LHC0821/2026TI-match-ball-system/hardware/mech/顶端一体件.SLDASM

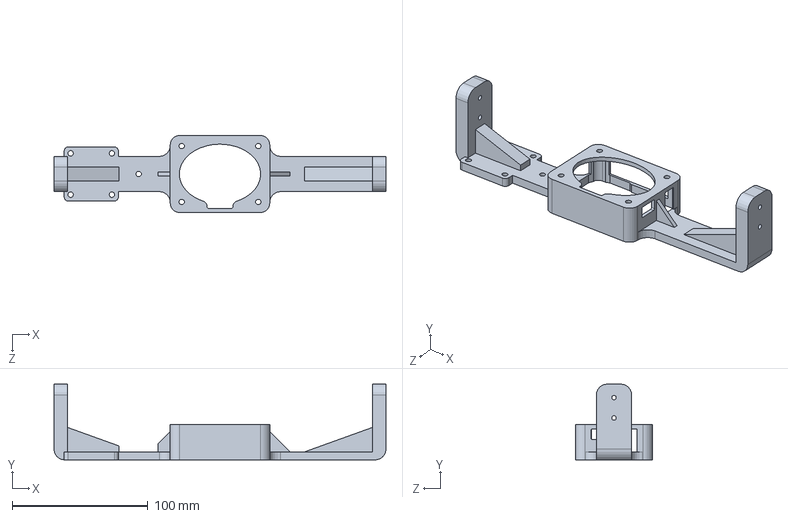
[picture p1: CAD file, 2026-10-28]
hardware/mech/顶端一体件.SLDASM
245.0 x 56.0 x 56.8 mm
