LHC0821/2026TI-match-ball-system/hardware/mech/起始转接件（合页）.SLDPRT

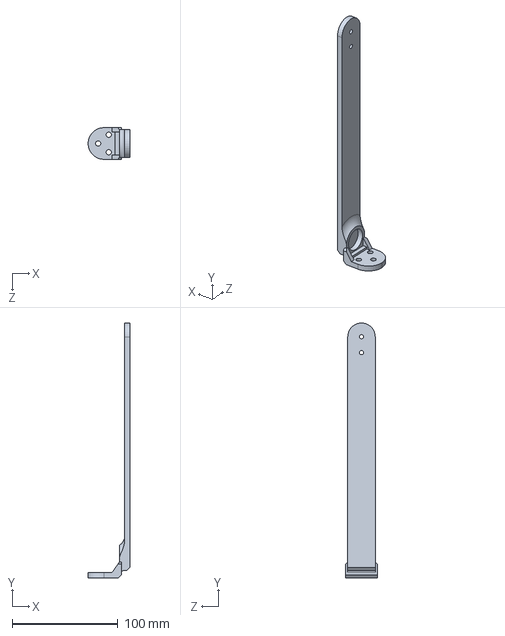
[picture p2: CAD file, 2026-10-28]
hardware/mech/起始转接件（合页）.SLDPRT
39.5 x 241.0 x 30.0 mm
