LHC0821/2026TI-match-ball-system/hardware/mech/定向轮支架.SLDPRT

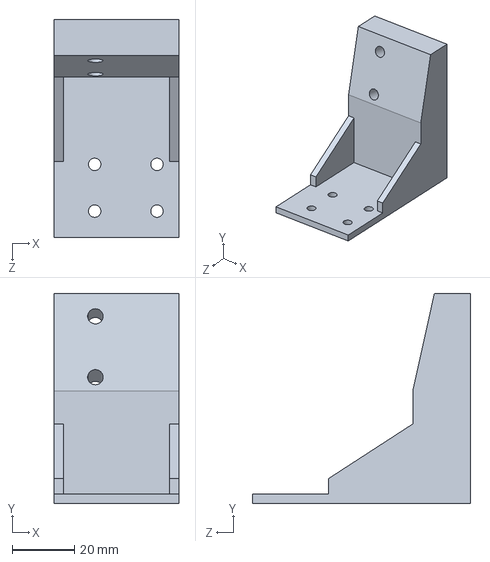
[picture p3: CAD file, 2026-10-28]
hardware/mech/定向轮支架.SLDPRT
40.0 x 67.4 x 70.0 mm
