LHC0821/2026TI-match-ball-system/hardware/mech/24v电池盒.SLDPRT

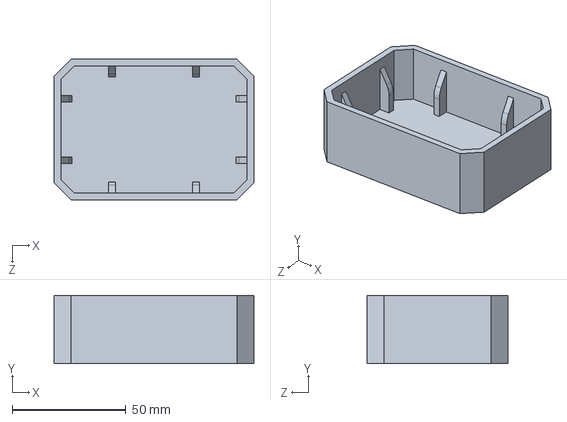
[picture p4: CAD file, 2026-10-28]
hardware/mech/24v电池盒.SLDPRT
88.0 x 30.0 x 62.0 mm
