LHC0821/2026TI-match-ball-system/hardware/mech/达妙MC02连接板.SLDPRT

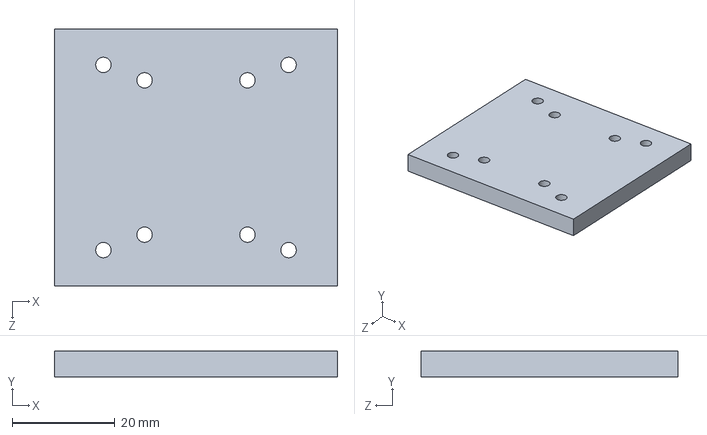
[picture p5: CAD file, 2026-10-28]
hardware/mech/达妙MC02连接板.SLDPRT
55.0 x 5.00 x 50.0 mm
