LHC0821/2026TI-match-ball-system/hardware/mech/内啮合末端圆柱齿轮256×2.SLDPRT

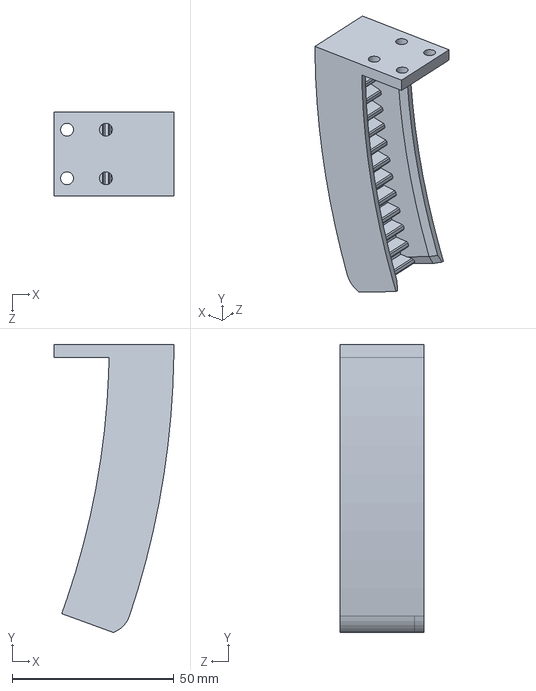
[picture p6: CAD file, 2026-10-28]
hardware/mech/内啮合末端圆柱齿轮256×2.SLDPRT
37.0 x 88.9 x 26.0 mm
