LHC0821/2026TI-match-ball-system/hardware/mech/达妙开发板（简约版）.SLDPRT

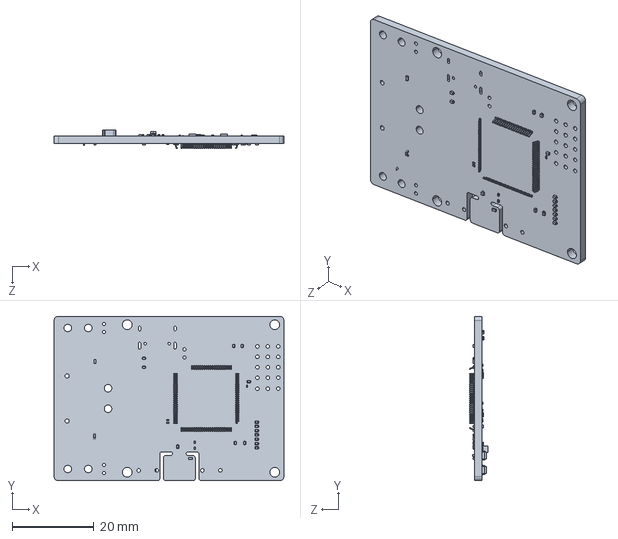
[picture p7: CAD file, 2026-10-28]
hardware/mech/达妙开发板（简约版）.SLDPRT
56.1 x 40.1 x 4.93 mm
