LHC0821/2026TI-match-ball-system/hardware/mech/万向轮（简易版）.SLDPRT

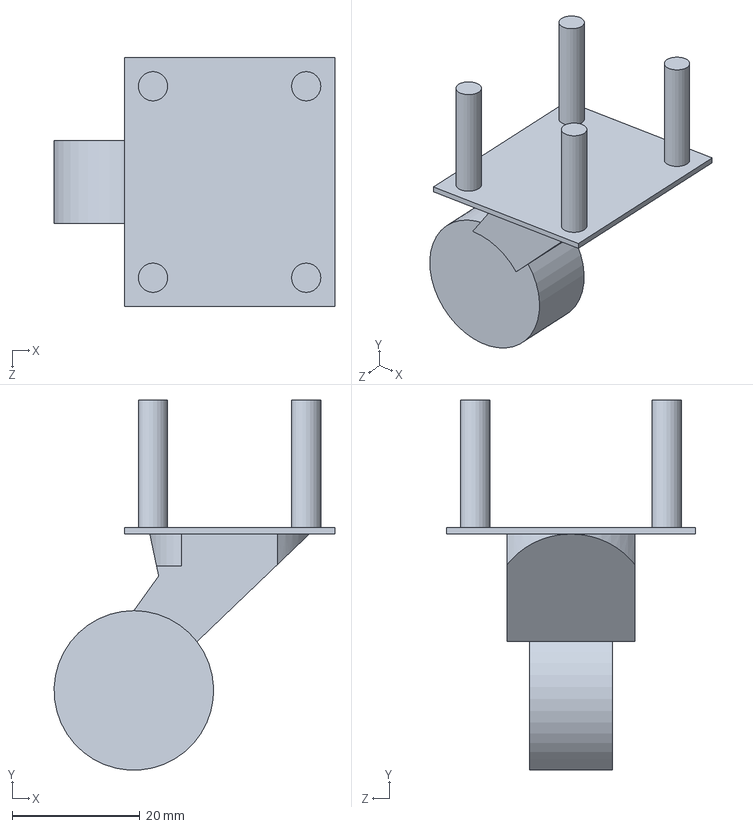
[picture p8: CAD file, 2026-10-28]
hardware/mech/万向轮（简易版）.SLDPRT
44.0 x 58.0 x 39.0 mm
