LHC0821/2026TI-match-ball-system/hardware/mech/铰链（长）.SLDPRT

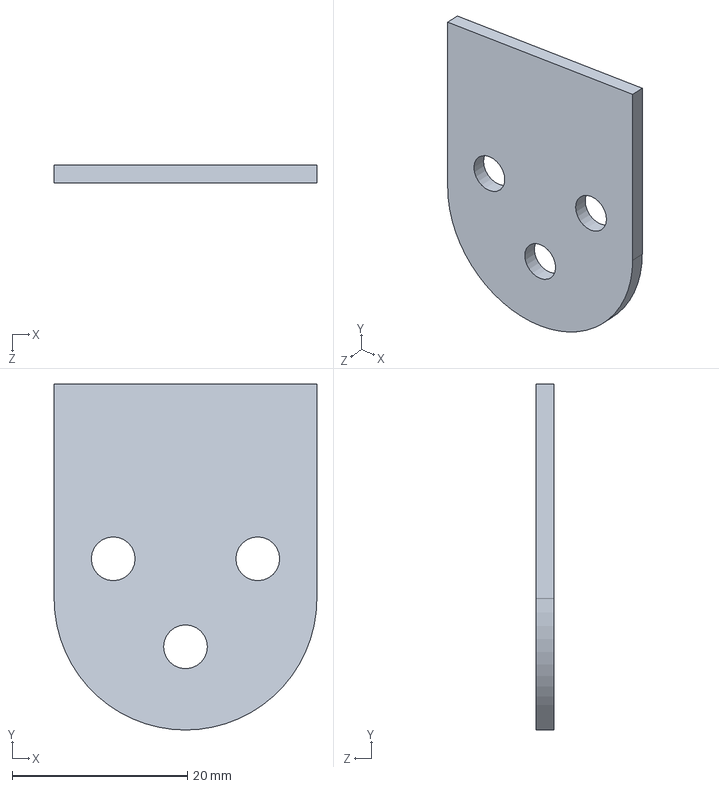
[picture p9: CAD file, 2026-10-28]
hardware/mech/铰链（长）.SLDPRT
30.0 x 39.5 x 2.00 mm
