LHC0821/2026TI-match-ball-system/hardware/mech/关节电机固定架.SLDPRT

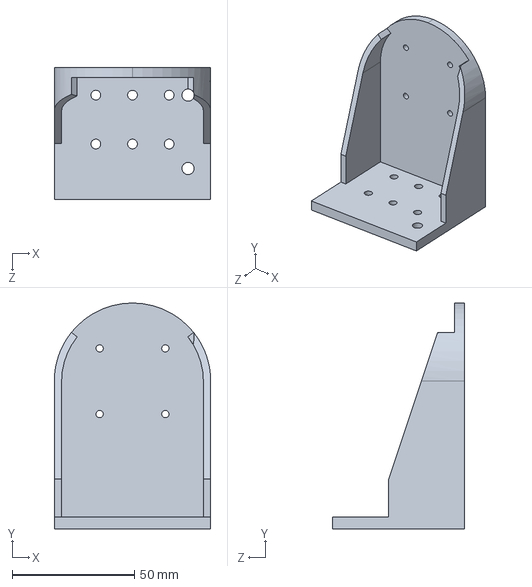
[picture p10: CAD file, 2026-10-28]
hardware/mech/关节电机固定架.SLDPRT
64.0 x 92.4 x 54.0 mm
