LHC0821/2026TI-match-ball-system/hardware/mech/管道左固定架.SLDPRT

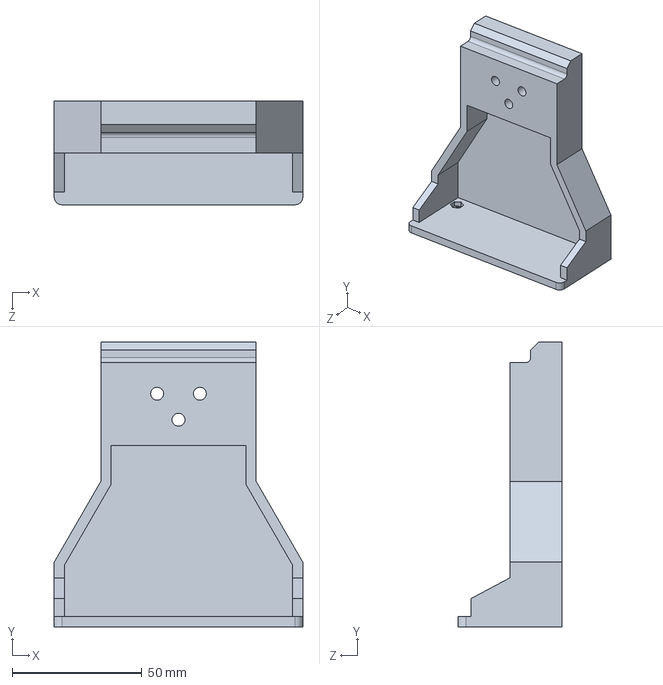
[picture p11: CAD file, 2026-10-28]
hardware/mech/管道左固定架.SLDPRT
96.0 x 110.0 x 40.0 mm
