LHC0821/2026TI-match-ball-system/hardware/mech/铜柱（单通M3长25+5）【灰度传感器】.SLDPRT

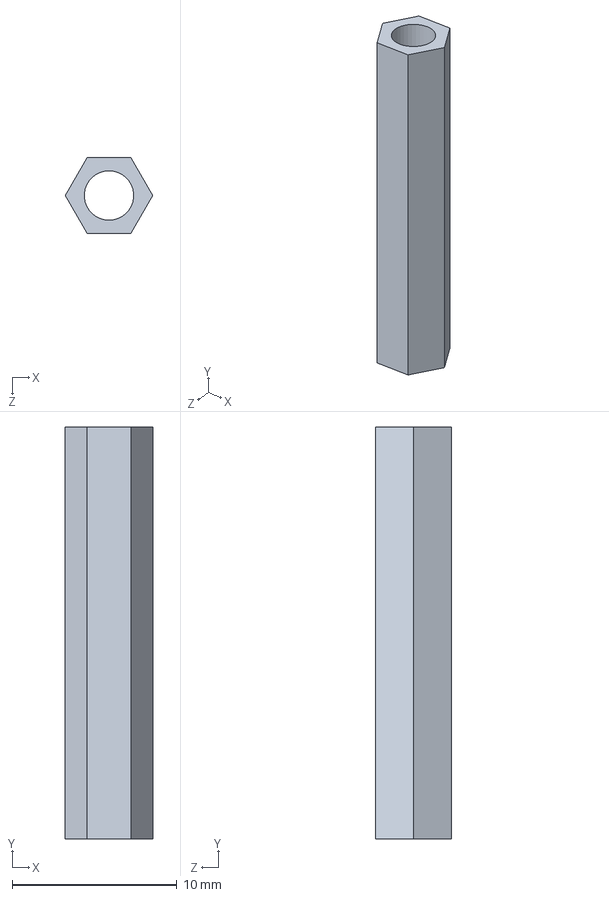
[picture p12: CAD file, 2026-10-28]
hardware/mech/铜柱（单通M3长25+5）【灰度传感器】.SLDPRT
5.31 x 25.0 x 4.60 mm
