LHC0821/2026TI-match-ball-system/hardware/mech/电池.SLDPRT

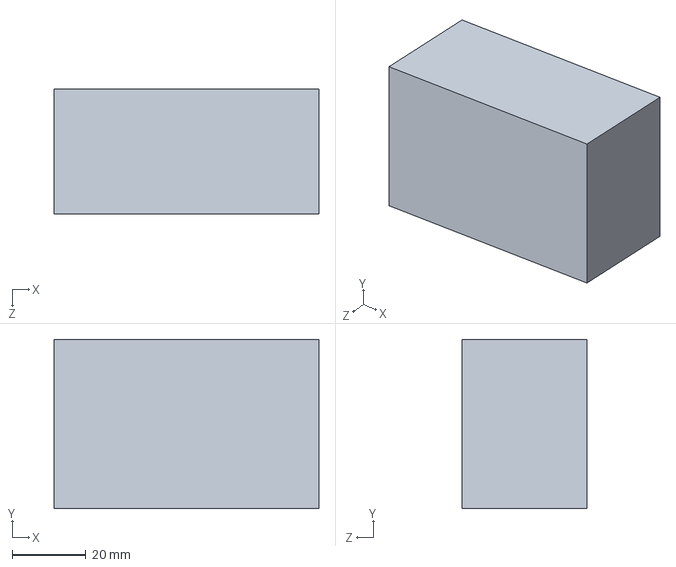
[picture p13: CAD file, 2026-10-28]
hardware/mech/电池.SLDPRT
72.0 x 46.0 x 34.0 mm
