LHC0821/2026TI-match-ball-system/hardware/mech/直流电机—MG513X霍尔编码器+支架+65mm轮子（客户图）.SLDPRT

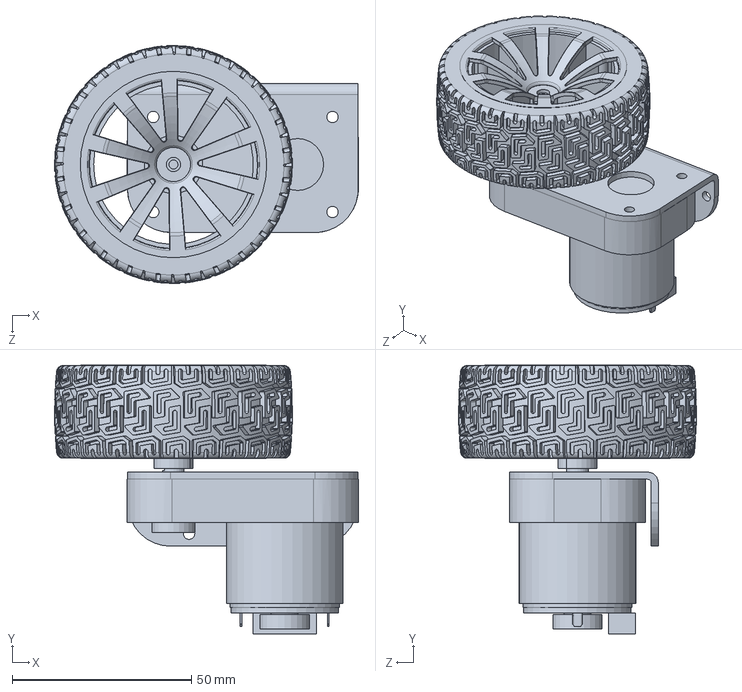
[picture p14: CAD file, 2026-10-28]
hardware/mech/直流电机—MG513X霍尔编码器+支架+65mm轮子（客户图）.SLDPRT
84.8 x 74.9 x 66.4 mm
