LHC0821/2026TI-match-ball-system/hardware/mech/后壳.SLDPRT

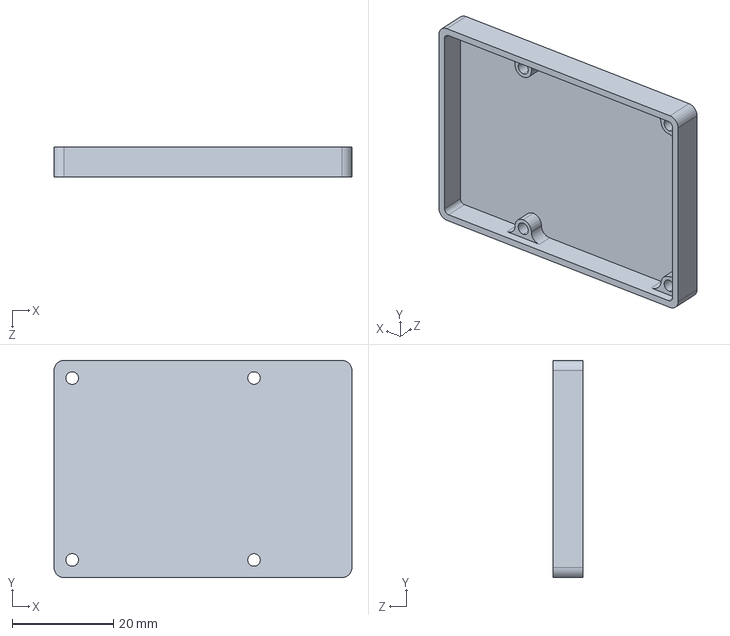
[picture p15: CAD file, 2026-10-28]
hardware/mech/后壳.SLDPRT
59.0 x 43.0 x 6.00 mm
