LHC0821/2026TI-match-ball-system/hardware/mech/主动轮圆柱齿轮27×2【驱动】.SLDPRT

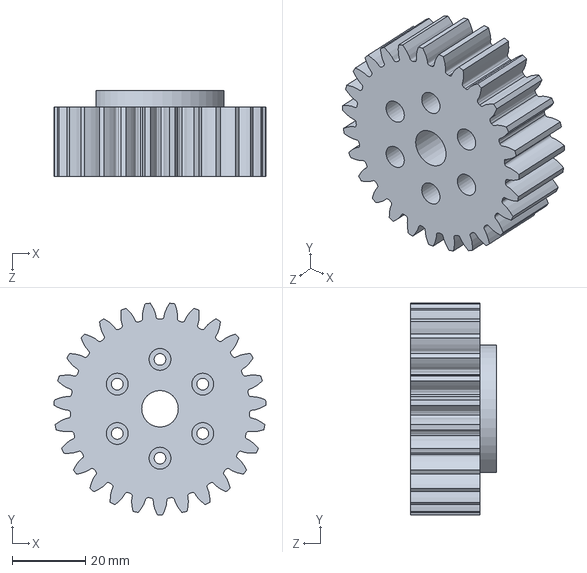
[picture p16: CAD file, 2026-10-28]
hardware/mech/主动轮圆柱齿轮27×2【驱动】.SLDPRT
58.0 x 57.9 x 23.5 mm
