LHC0821/2026TI-match-ball-system/hardware/mech/小车底板.SLDPRT

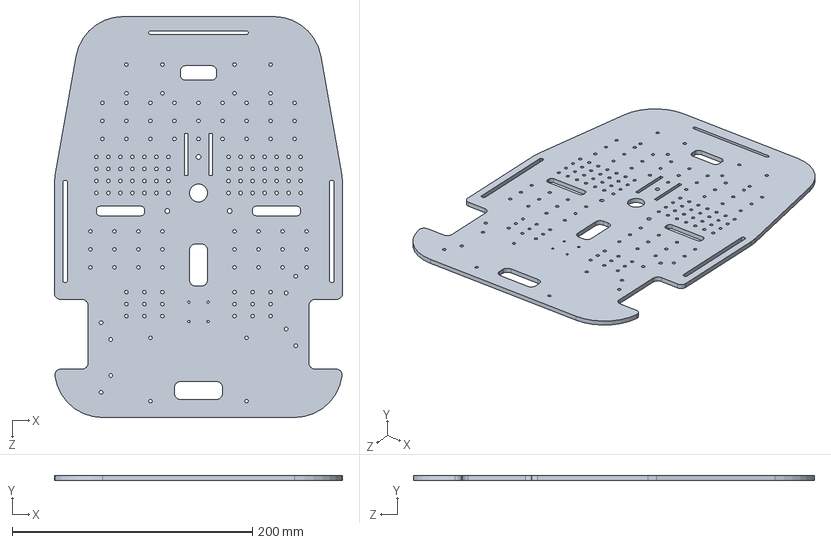
[picture p17: CAD file, 2026-10-28]
hardware/mech/小车底板.SLDPRT
240.0 x 4.00 x 334.0 mm
