LHC0821/2026TI-match-ball-system/hardware/mech/ppr水管.SLDPRT

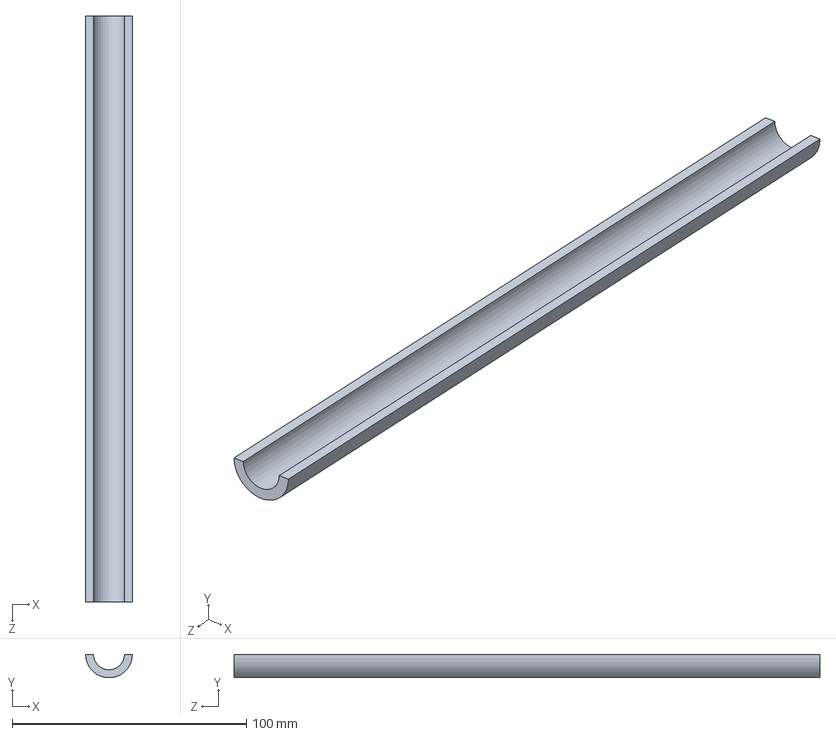
[picture p18: CAD file, 2026-10-28]
hardware/mech/ppr水管.SLDPRT
20.0 x 9.97 x 250.0 mm
