LHC0821/2026TI-match-ball-system/hardware/mech/开发板.SLDPRT

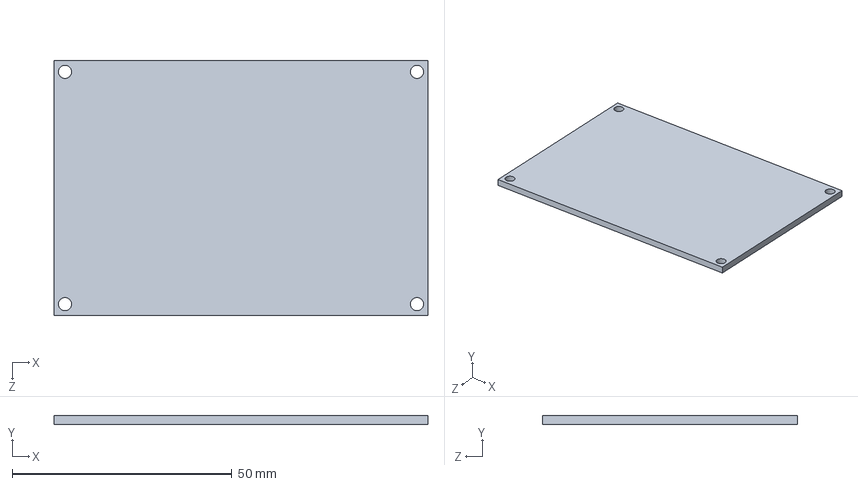
[picture p19: CAD file, 2026-10-28]
hardware/mech/开发板.SLDPRT
85.0 x 2.00 x 58.0 mm
