LHC0821/2026TI-match-ball-system/hardware/mech/定向轮.SLDPRT

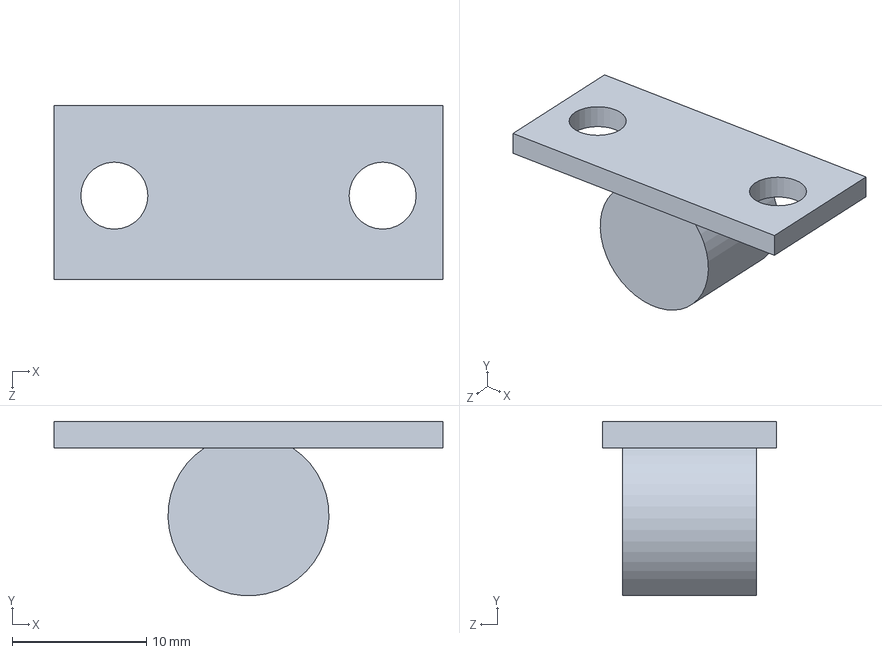
[picture p20: CAD file, 2026-10-28]
hardware/mech/定向轮.SLDPRT
29.0 x 13.0 x 13.0 mm
