LHC0821/2026TI-match-ball-system/hardware/mech/灰度传感器模块.SLDPRT

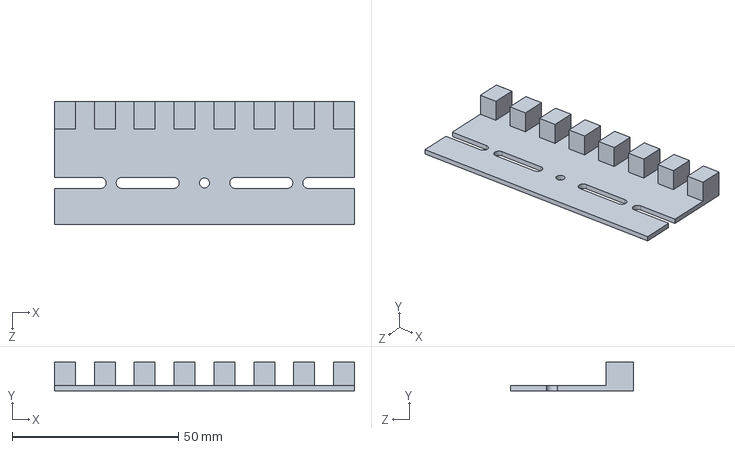
[picture p21: CAD file, 2026-10-28]
hardware/mech/灰度传感器模块.SLDPRT
90.3 x 8.60 x 37.0 mm
