LHC0821/2026TI-match-ball-system/hardware/mech/末端.SLDPRT

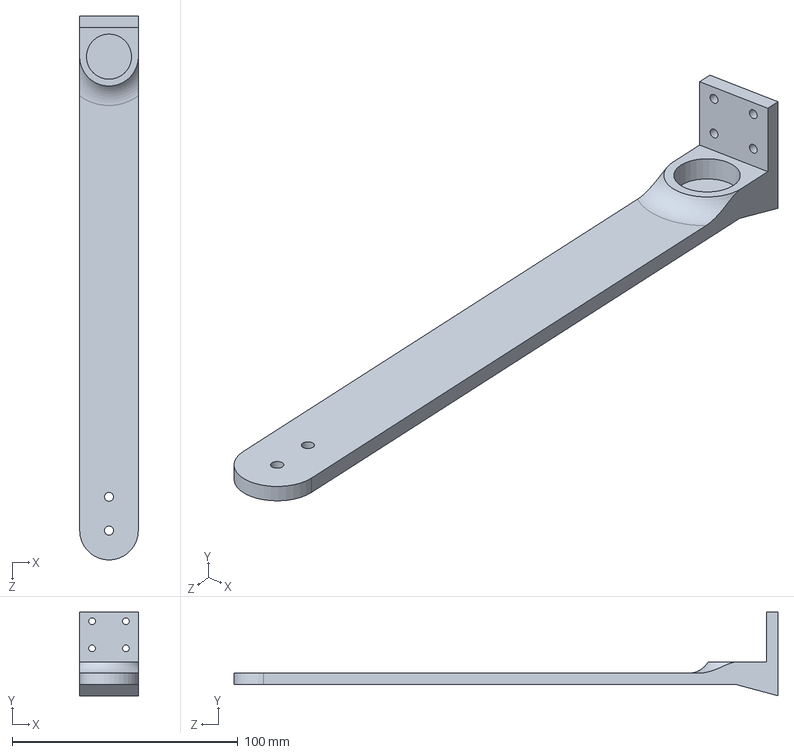
[picture p22: CAD file, 2026-10-28]
hardware/mech/末端.SLDPRT
26.0 x 37.0 x 241.0 mm
