LHC0821/2026TI-match-ball-system/hardware/mech/开发板【连接板】.SLDPRT

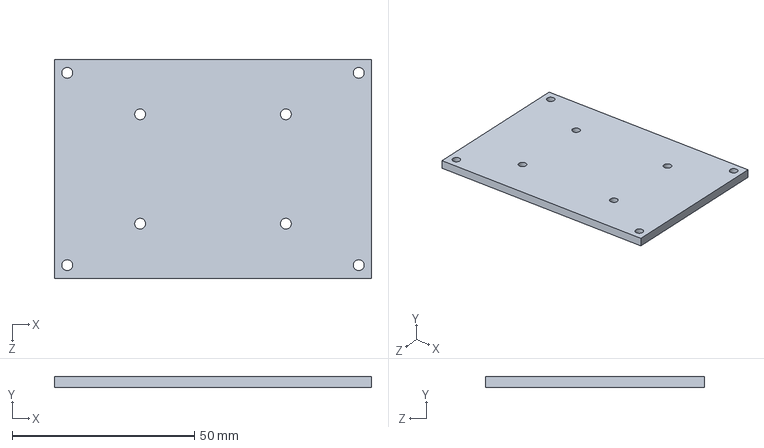
[picture p23: CAD file, 2026-10-28]
hardware/mech/开发板【连接板】.SLDPRT
87.0 x 3.00 x 60.0 mm
