LHC0821/2026TI-match-ball-system/hardware/mech/DM-J4340-2EC-V1.1_3d_20260325_1.SLDASM

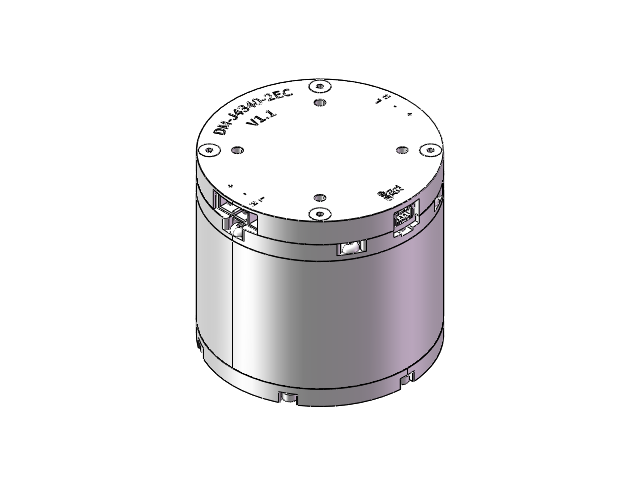
[picture p24: CAD file, 2026-10-28]
hardware/mech/DM-J4340-2EC-V1.1_3d_20260325_1.SLDASM
DM_4340_3D_1_1_1_1_4.stp
4340__3D_20240814_1_2_4.stp
4310_202409130001.stp
G43_V1_1_3-230824_4.stp
4040V300.stp
M2_5-800.stp x 6
M2_5-L4.stp x 4
M2_5-L6.stp x 7
_M2_5-100001.stp x 4
