LHC0821/2026TI-match-ball-system/hardware/mech/小车总装.SLDASM

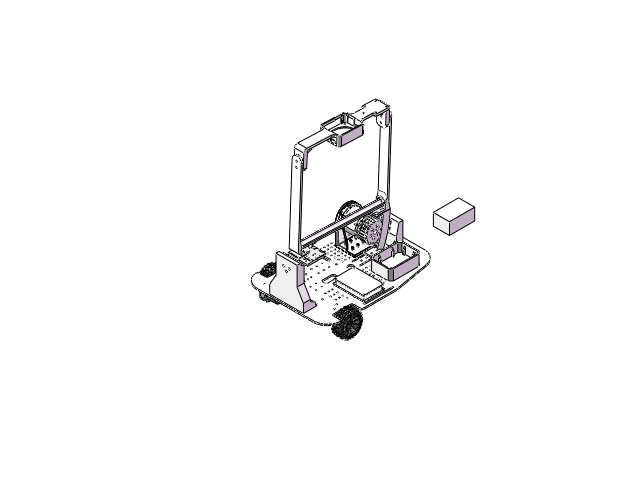
[picture p25: CAD file, 2026-10-28]
hardware/mech/小车总装.SLDASM
小车底板
直流电机—MG513X霍尔编码器+支架+65mm轮子（客户图） x 2
万向轮（简易版） x 2
灰度传感器模块
铜柱（单通M3长25+5）【灰度传感器】 x 2
ppr水管
管道左固定架
Repaired_顶
末端
起始转接件（合页）
铰链
铰链（长）
DM_4340_3D_1_1_1_1_4.stp
4340__3D_20240814_1_2_4.stp
4310_202409130001.stp
G43_V1_1_3-230824_4.stp
4040V300.stp
M2_5-800.stp x 6
M2_5-L4.stp x 4
M2_5-L6.stp x 7
_M2_5-100001.stp x 4
主动轮圆柱齿轮27×2【驱动】
关节电机固定架
内啮合末端圆柱齿轮256×2
定向轮支架
电池
定向轮
达妙开发板（简约版）
达妙MC02连接板
开发板【连接板】
开发板
24v电池盒
