LHC0821/2026TI-match-ball-system/(list of files, cad)

Other CAD files:
hardware/mech/铰链.SLDPRT
hardware/mech/Repaired_顶.SLDPRT
