LHC0821/2026TI-match-ball-system/src/device/imu/bmi088.c

#include "bmi088.h"
#include "imu_attitude.h"

#include <math.h>
#include <stdbool.h>
#include <string.h>

// ! ========================= 变 量 声 明 ========================= ! //

#define BMI088_TEMP_FACTOR                  0.125f
#define BMI088_TEMP_OFFSET                  23.0f

#define BMI088_WRITE_ACCEL_REG_NUM          6U
#define BMI088_WRITE_GYRO_REG_NUM           6U

#define BMI088_LONG_DELAY_TIME              80U
#define BMI088_COM_WAIT_SENSOR_TIME         150U

#define BMI088_ACCEL_3G_SEN                 0.0008974358974f
#define BMI088_GYRO_2000_SEN                0.0010652644360316953f

#define BMI088_DMA_GYRO_FRAME_LEN           7U
#define BMI088_DMA_ACCEL_FRAME_LEN          8U
#define BMI088_SPI_DUMMY_BYTE               0x55U
#define BMI088_TEMP_UPDATE_PERIOD_US        100000U
#define BMI088_GYRO_STALE_TIMEOUT_US        10000U
#define BMI088_ACCEL_STALE_TIMEOUT_US       10000U
#define BMI088_ACCEL_NORM_MIN_MPS2          3.0f
#define BMI088_ACCEL_NORM_MAX_MPS2          20.0f

#define BMI088_ACC_CHIP_ID                  0x00U
#define BMI088_ACC_CHIP_ID_VALUE            0x1EU
#define BMI088_ACCEL_XOUT_L                 0x12U
#define BMI088_TEMP_M                       0x22U
#define BMI088_ACC_CONF                     0x40U
#define BMI088_ACC_CONF_MUST_SET            0x80U
#define BMI088_ACC_NORMAL                   (0x2U << 4)
#define BMI088_ACC_800_HZ                   (0xBU << 0)
#define BMI088_ACC_RANGE                    0x41U
#define BMI088_ACC_RANGE_3G                 (0x0U << 0)
#define BMI088_INT1_IO_CTRL                 0x53U
#define BMI088_ACC_INT1_IO_ENABLE           (0x1U << 3)
#define BMI088_ACC_INT1_GPIO_PP             (0x0U << 2)
#define BMI088_ACC_INT1_GPIO_HIGH           (0x1U << 1)
#define BMI088_INT_MAP_DATA                 0x58U
#define BMI088_ACC_INT1_DRDY_INTERRUPT      (0x1U << 2)
#define BMI088_ACC_PWR_CONF                 0x7CU
#define BMI088_ACC_PWR_ACTIVE_MODE          0x00U
#define BMI088_ACC_PWR_CTRL                 0x7DU
#define BMI088_ACC_ENABLE_ACC_ON            0x04U
#define BMI088_ACC_SOFTRESET                0x7EU
#define BMI088_ACC_SOFTRESET_VALUE          0xB6U

#define BMI088_GYRO_CHIP_ID                 0x00U
#define BMI088_GYRO_CHIP_ID_VALUE           0x0FU
#define BMI088_GYRO_X_L                     0x02U
#define BMI088_GYRO_RANGE                   0x0FU
#define BMI088_GYRO_2000                    (0x0U << 0)
#define BMI088_GYRO_BANDWIDTH               0x10U
#define BMI088_GYRO_BANDWIDTH_MUST_SET      0x80U
#define BMI088_GYRO_1000_116_HZ             0x02U
#define BMI088_GYRO_LPM1                    0x11U
#define BMI088_GYRO_NORMAL_MODE             0x00U
#define BMI088_GYRO_SOFTRESET               0x14U
#define BMI088_GYRO_SOFTRESET_VALUE         0xB6U
#define BMI088_GYRO_CTRL                    0x15U
#define BMI088_DRDY_ON                      0x80U
#define BMI088_GYRO_INT3_INT4_IO_CONF       0x16U
#define BMI088_GYRO_INT3_GPIO_PP            (0x0U << 1)
#define BMI088_GYRO_INT3_GPIO_HIGH          (0x1U << 0)
#define BMI088_GYRO_INT3_INT4_IO_MAP        0x18U
#define BMI088_GYRO_DRDY_IO_INT3            0x01U

typedef enum {
    BMI088_DMA_IDLE = 0,
    BMI088_DMA_GYRO,
    BMI088_DMA_ACCEL
} Bmi088DmaState;

typedef enum {
    BMI088_ASYNC_NEXT_GYRO = 0,
    BMI088_ASYNC_NEXT_ACCEL
} Bmi088AsyncNext;

// ! ========================= 私 有 函 数 声 明 ========================= ! //

/**
 * @brief bmi088_init_async 内部辅助函数
 * @param config 配置结构体指针
 * @return 状态码
 */
static ImuStatus bmi088_init_async(const void* config);
/**
 * @brief bmi088_init_blocking 内部辅助函数
 * @param config 配置结构体指针
 * @return 状态码
 */
static ImuStatus bmi088_init_blocking(const void* config);
/**
 * @brief bmi088_init_common 内部辅助函数
 * @param config 配置结构体指针
 * @param require_async_ops 参数值
 * @return 状态码
 */
static ImuStatus bmi088_init_common(const void* config, bool require_async_ops);
/**
 * @brief bmi088_update 内部辅助函数
 * @return 状态码
 */
static ImuStatus bmi088_update(void);
/**
 * @brief bmi088_blocking_update 内部辅助函数
 * @return 状态码
 */
static ImuStatus bmi088_blocking_update(void);
/**
 * @brief bmi088_get_acc 内部辅助函数
 * @return 返回值
 */
static ImuAcc bmi088_get_acc(void);
/**
 * @brief bmi088_get_gyro 内部辅助函数
 * @return 返回值
 */
static ImuGyro bmi088_get_gyro(void);
/**
 * @brief bmi088_get_gyro_bias 内部辅助函数
 * @return 返回值
 */
static ImuGyro bmi088_get_gyro_bias(void);
/**
 * @brief bmi088_get_gyro_corrected 内部辅助函数
 * @return 返回值
 */
static ImuGyro bmi088_get_gyro_corrected(void);
/**
 * @brief bmi088_get_angle 内部辅助函数
 * @return 返回值
 */
static ImuAngle bmi088_get_angle(void);
/**
 * @brief bmi088_get_sample 内部辅助函数
 * @param sample 样本数据指针
 * @return 状态码
 */
static ImuStatus bmi088_get_sample(ImuSample* sample);
/**
 * @brief bmi088_status_str 内部辅助函数
 * @param status 状态值
 * @return 字符串指针
 */
static const char* bmi088_status_str(ImuStatus status);

/**
 * @brief bmi088_gpio_init 内部辅助函数
 */
static void bmi088_gpio_init(void);
/**
 * @brief bmi088_com_init 内部辅助函数
 */
static void bmi088_com_init(void);
/**
 * @brief bmi088_delay_ms 内部辅助函数
 * @param ms 时间，单位 ms
 */
static void bmi088_delay_ms(uint16_t ms);
/**
 * @brief bmi088_delay_us 内部辅助函数
 * @param us 时间，单位 us
 */
static void bmi088_delay_us(uint16_t us);
/**
 * @brief bmi088_accel_cs_low 内部辅助函数
 */
static void bmi088_accel_cs_low(void);
/**
 * @brief bmi088_accel_cs_high 内部辅助函数
 */
static void bmi088_accel_cs_high(void);
/**
 * @brief bmi088_gyro_cs_low 内部辅助函数
 */
static void bmi088_gyro_cs_low(void);
/**
 * @brief bmi088_gyro_cs_high 内部辅助函数
 */
static void bmi088_gyro_cs_high(void);
/**
 * @brief bmi088_read_write_byte 内部辅助函数
 * @param tx_data 参数值
 * @return 返回值
 */
static uint8_t bmi088_read_write_byte(uint8_t tx_data);
/**
 * @brief bmi088_get_spi_handle 内部辅助函数
 * @return 结果指针
 */
static void* bmi088_get_spi_handle(void);
/**
 * @brief bmi088_spi_transmit_receive_dma 内部辅助函数
 * @param tx_data 参数值
 * @param rx_data 参数值
 * @param len 数据长度
 * @return true 表示成功或条件成立，false 表示失败或条件不成立
 */
static bool bmi088_spi_transmit_receive_dma(uint8_t* tx_data, uint8_t* rx_data, uint16_t len);
/**
 * @brief bmi088_now_ms 内部辅助函数
 * @return 返回值
 */
static uint32_t bmi088_now_ms(void);
/**
 * @brief bmi088_now_us 内部辅助函数
 * @return 返回值
 */
static uint32_t bmi088_now_us(void);
/**
 * @brief bmi088_config_is_valid 内部辅助函数
 * @param config 配置结构体指针
 * @param require_async_ops 参数值
 * @return true 表示成功或条件成立，false 表示失败或条件不成立
 */
static bool bmi088_config_is_valid(const Bmi088Config* config, bool require_async_ops);
/**
 * @brief bmi088_attitude_init 内部辅助函数
 * @param config 配置结构体指针
 */
static void bmi088_attitude_init(const ImuAttitudeConfig* config);
/**
 * @brief bmi088_attitude_update 内部辅助函数
 */
static void bmi088_attitude_update(void);

/**
 * @brief bmi088_device_init 内部辅助函数
 * @return 返回值
 */
static Bmi088Error bmi088_device_init(void);
/**
 * @brief bmi088_accel_init 内部辅助函数
 * @return 返回值
 */
static Bmi088Error bmi088_accel_init(void);
/**
 * @brief bmi088_gyro_init 内部辅助函数
 * @return 返回值
 */
static Bmi088Error bmi088_gyro_init(void);
/**
 * @brief bmi088_read_gyro_raw 内部辅助函数
 * @param gyro 参数值
 */
static void bmi088_read_gyro_raw(float gyro[3]);
/**
 * @brief bmi088_read_accel_raw 内部辅助函数
 * @param accel 参数值
 */
static void bmi088_read_accel_raw(float accel[3]);
/**
 * @brief bmi088_read_temp_raw 内部辅助函数
 * @param temperature 参数值
 */
static void bmi088_read_temp_raw(float* temperature);
/**
 * @brief bmi088_async_init 内部辅助函数
 */
static void bmi088_async_init(void);
/**
 * @brief bmi088_notify_gyro_data_ready 内部辅助函数
 */
static void bmi088_notify_gyro_data_ready(void);
/**
 * @brief bmi088_notify_accel_data_ready 内部辅助函数
 */
static void bmi088_notify_accel_data_ready(void);
/**
 * @brief bmi088_async_poll 内部辅助函数
 * @return true 表示成功或条件成立，false 表示失败或条件不成立
 */
static bool bmi088_async_poll(void);
/**
 * @brief bmi088_async_get_gyro 内部辅助函数
 * @param gyro 参数值
 * @return true 表示成功或条件成立，false 表示失败或条件不成立
 */
static bool bmi088_async_get_gyro(float gyro[3]);
/**
 * @brief bmi088_async_get_accel 内部辅助函数
 * @param accel 参数值
 * @return true 表示成功或条件成立，false 表示失败或条件不成立
 */
static bool bmi088_async_get_accel(float accel[3]);
/**
 * @brief bmi088_spi_txrx_complete 内部辅助函数
 * @param spi_handle 参数值
 */
static void bmi088_spi_txrx_complete(void* spi_handle);
/**
 * @brief bmi088_spi_error 内部辅助函数
 * @param spi_handle 参数值
 */
static void bmi088_spi_error(void* spi_handle);

/**
 * @brief bmi088_write_single_reg 内部辅助函数
 * @param reg 参数值
 * @param data 数据缓冲区指针
 */
static void bmi088_write_single_reg(uint8_t reg, uint8_t data);
/**
 * @brief bmi088_read_single_reg 内部辅助函数
 * @param reg 参数值
 * @param return_data 参数值
 */
static void bmi088_read_single_reg(uint8_t reg, uint8_t* return_data);
/**
 * @brief bmi088_accel_write_single_reg 内部辅助函数
 * @param reg 参数值
 * @param data 数据缓冲区指针
 */
static void bmi088_accel_write_single_reg(uint8_t reg, uint8_t data);
/**
 * @brief bmi088_accel_read_single_reg 内部辅助函数
 * @param reg 参数值
 * @param data 数据缓冲区指针
 */
static void bmi088_accel_read_single_reg(uint8_t reg, uint8_t* data);
/**
 * @brief bmi088_accel_read_burst 内部辅助函数
 * @param reg 参数值
 * @param buf 参数值
 * @param len 数据长度
 */
static void bmi088_accel_read_burst(uint8_t reg, uint8_t* buf, uint8_t len);
/**
 * @brief bmi088_gyro_write_single_reg 内部辅助函数
 * @param reg 参数值
 * @param data 数据缓冲区指针
 */
static void bmi088_gyro_write_single_reg(uint8_t reg, uint8_t data);
/**
 * @brief bmi088_gyro_read_single_reg 内部辅助函数
 * @param reg 参数值
 * @param data 数据缓冲区指针
 */
static void bmi088_gyro_read_single_reg(uint8_t reg, uint8_t* data);
/**
 * @brief bmi088_release_all_cs 内部辅助函数
 */
static void bmi088_release_all_cs(void);
/**
 * @brief bmi088_start_gyro_dma 内部辅助函数
 * @return true 表示成功或条件成立，false 表示失败或条件不成立
 */
static bool bmi088_start_gyro_dma(void);
/**
 * @brief bmi088_start_accel_dma 内部辅助函数
 * @return true 表示成功或条件成立，false 表示失败或条件不成立
 */
static bool bmi088_start_accel_dma(void);
/**
 * @brief bmi088_parse_gyro_dma_buffer 内部辅助函数
 */
static void bmi088_parse_gyro_dma_buffer(void);
/**
 * @brief bmi088_parse_accel_dma_buffer 内部辅助函数
 */
static void bmi088_parse_accel_dma_buffer(void);
/**
 * @brief bmi088_copy_vector3 内部辅助函数
 * @param dst 参数值
 * @param src 参数值
 */
static void bmi088_copy_vector3(float dst[3], const float src[3]);
/**
 * @brief bmi088_dma_prepare_txrx 内部辅助函数
 * @param len 数据长度
 */
static void bmi088_dma_prepare_txrx(uint16_t len);
/**
 * @brief bmi088_dma_maintain_before_start 内部辅助函数
 * @param len 数据长度
 */
static void bmi088_dma_maintain_before_start(uint16_t len);
/**
 * @brief bmi088_dma_maintain_after_finish 内部辅助函数
 * @param len 数据长度
 */
static void bmi088_dma_maintain_after_finish(uint16_t len);
/**
 * @brief bmi088_update_temp_cache 内部辅助函数
 * @param now_us 参数值
 * @param sample_flags 参数值
 */
static void bmi088_update_temp_cache(uint32_t now_us, uint8_t* sample_flags);
/**
 * @brief bmi088_acc_norm 内部辅助函数
 * @param acc 参数值
 * @return 返回值
 */
static float bmi088_acc_norm(const float acc[3]);
/**
 * @brief bmi088_acc_sample_is_reasonable 内部辅助函数
 * @param acc 参数值
 * @return true 表示成功或条件成立，false 表示失败或条件不成立
 */
static bool bmi088_acc_sample_is_reasonable(const float acc[3]);
/**
 * @brief bmi088_calc_gyro_temp_comp 内部辅助函数
 * @return 返回值
 */
static ImuGyro bmi088_calc_gyro_temp_comp(void);

/**
 * @brief bmi088_make_acc 内部辅助函数
 * @param acc 参数值
 * @return 返回值
 */
static ImuAcc bmi088_make_acc(const float acc[3]);
/**
 * @brief bmi088_make_gyro 内部辅助函数
 * @param gyro 参数值
 * @return 返回值
 */
static ImuGyro bmi088_make_gyro(const float gyro[3]);

// ! ========================= 变 量 声 明 ========================= ! //

static const Bmi088PortOps* s_bmi088_ops = 0;
static float s_bmi088_accel_sen = BMI088_ACCEL_3G_SEN;
static float s_bmi088_gyro_sen = BMI088_GYRO_2000_SEN;
static uint16_t s_bmi088_accel_int_pin = 0U;
static uint16_t s_bmi088_gyro_int_pin = 0U;
static volatile Bmi088DmaState s_bmi088_dma_state = BMI088_DMA_IDLE;
static volatile bool s_bmi088_gyro_pending = false;
static volatile bool s_bmi088_accel_pending = false;
static volatile bool s_bmi088_gyro_ready = false;
static volatile bool s_bmi088_accel_ready = false;

__attribute__((section(".ram_d2"), aligned(32))) static uint8_t s_bmi088_tx[BMI088_DMA_ACCEL_FRAME_LEN];
__attribute__((section(".ram_d2"), aligned(32))) static uint8_t s_bmi088_rx[BMI088_DMA_ACCEL_FRAME_LEN];

static float s_bmi088_gyro_dma[3];
static float s_bmi088_accel_dma[3];

static const uint8_t s_bmi088_accel_reg_init[BMI088_WRITE_ACCEL_REG_NUM][3] = {
    {BMI088_ACC_PWR_CTRL, BMI088_ACC_ENABLE_ACC_ON, BMI088_ERROR_ACC_PWR_CTRL},
    {BMI088_ACC_PWR_CONF, BMI088_ACC_PWR_ACTIVE_MODE, BMI088_ERROR_ACC_PWR_CONF},
    {BMI088_ACC_CONF, BMI088_ACC_NORMAL | BMI088_ACC_800_HZ | BMI088_ACC_CONF_MUST_SET, BMI088_ERROR_ACC_CONF},
    {BMI088_ACC_RANGE, BMI088_ACC_RANGE_3G, BMI088_ERROR_ACC_RANGE},
    {BMI088_INT1_IO_CTRL, BMI088_ACC_INT1_IO_ENABLE | BMI088_ACC_INT1_GPIO_PP | BMI088_ACC_INT1_GPIO_HIGH, BMI088_ERROR_INT1_IO_CTRL},
    {BMI088_INT_MAP_DATA, BMI088_ACC_INT1_DRDY_INTERRUPT, BMI088_ERROR_INT_MAP_DATA}
};

static const uint8_t s_bmi088_gyro_reg_init[BMI088_WRITE_GYRO_REG_NUM][3] = {
    {BMI088_GYRO_RANGE, BMI088_GYRO_2000, BMI088_ERROR_GYRO_RANGE},
    {BMI088_GYRO_BANDWIDTH, BMI088_GYRO_1000_116_HZ | BMI088_GYRO_BANDWIDTH_MUST_SET, BMI088_ERROR_GYRO_BANDWIDTH},
    {BMI088_GYRO_LPM1, BMI088_GYRO_NORMAL_MODE, BMI088_ERROR_GYRO_LPM1},
    {BMI088_GYRO_CTRL, BMI088_DRDY_ON, BMI088_ERROR_GYRO_CTRL},
    {BMI088_GYRO_INT3_INT4_IO_CONF, BMI088_GYRO_INT3_GPIO_PP | BMI088_GYRO_INT3_GPIO_HIGH, BMI088_ERROR_GYRO_INT3_INT4_IO_CONF},
    {BMI088_GYRO_INT3_INT4_IO_MAP, BMI088_GYRO_DRDY_IO_INT3, BMI088_ERROR_GYRO_INT3_INT4_IO_MAP}
};

static ImuAcc s_bmi088_acc = { 0.0f, 0.0f, 0.0f };
static ImuGyro s_bmi088_gyro = { 0.0f, 0.0f, 0.0f };
static ImuAngle s_bmi088_angle = { 0.0f, 0.0f, 0.0f };
static ImuSample s_bmi088_sample = { 0 };
static ImuAttitude s_bmi088_attitude = { 0 };
static bool s_bmi088_attitude_enabled = false;

static Bmi088Error s_bmi088_init_error = BMI088_ERROR_NO_ERROR;
static float s_bmi088_temp = 0.0f;
static bool s_bmi088_is_initialized = false;
static volatile Bmi088AsyncNext s_bmi088_async_next = BMI088_ASYNC_NEXT_GYRO;

/**
 * @brief BMI088 通用 IMU 实例
 */
const ImuInterface bmi088_instance = {
    .init = bmi088_init_async,
    .update = bmi088_update,
    .get_acc = bmi088_get_acc,
    .get_gyro = bmi088_get_gyro,
    .get_gyro_bias = bmi088_get_gyro_bias,
    .get_gyro_corrected = bmi088_get_gyro_corrected,
    .get_angle = bmi088_get_angle,
    .get_sample = bmi088_get_sample,
    .status_str = bmi088_status_str,
};

/**
 * @brief BMI088 阻塞式 IMU 实例
 */
const ImuInterface bmi088_blocking_instance = {
    .init = bmi088_init_blocking,
    .update = bmi088_blocking_update,
    .get_acc = bmi088_get_acc,
    .get_gyro = bmi088_get_gyro,
    .get_gyro_bias = bmi088_get_gyro_bias,
    .get_gyro_corrected = bmi088_get_gyro_corrected,
    .get_angle = bmi088_get_angle,
    .get_sample = bmi088_get_sample,
    .status_str = bmi088_status_str,
};

ImuStatus bmi088_make_config(Bmi088Config* config, const Bmi088PortOps* ops, const uint16_t accel_int_pin, const uint16_t gyro_int_pin) {
    if(config == 0 || ops == 0) {
        return IMU_STATUS_INVALID_PARAM;
    }

    config->ops = ops;
    config->accel_sen = BMI088_ACCEL_3G_SEN;
    config->gyro_sen = BMI088_GYRO_2000_SEN;
    config->accel_int_pin = accel_int_pin;
    config->gyro_int_pin = gyro_int_pin;
    config->attitude.mode = IMU_ATTITUDE_MAHONY_6AXIS;
    config->attitude.gyro_calib_samples = 2000U;
    config->attitude.acc_norm = 9.80665f;
    config->attitude.acc_norm_tolerance = 1.5f;
    config->attitude.max_acc_age_us = 20000U;
    config->attitude.gyro_calib_var_threshold = 0.01f;
    config->attitude.complementary_tau = 0.5f;
    config->attitude.mahony_kp = 2.0f;
    config->attitude.mahony_ki = 0.0f;
    config->attitude.mahony_ki_z = 0.0f;
    config->attitude.gyro_x_temp_coeff = 0.0f;
    config->attitude.gyro_y_temp_coeff = 0.0f;

    /**
     * 基于冷启动到约 33 C 升温日志的固定拟合：
     * bias_eff_z = gyro_z_bias_offset + gyro_z_temp_coeff * temp
     */
    config->attitude.gyro_z_temp_coeff = 0.000038f;
    config->attitude.gyro_z_bias_offset = 0.00090f;
    config->attitude.gyro_z_bias_temp_coeff = 0.0f;

    config->attitude.zru_gyro_threshold = 0.0f;
    config->attitude.zru_min_static_us = 0U;
    config->attitude.zru_bias_gain = 0.0f;

    return IMU_STATUS_OK;
}

// ! ========================= 接 口 函 数 实 现 ========================= ! //

/**
 * @brief 获取 BMI088 初始化错误码字符串
 */
const char* bmi088_error_str(Bmi088Error error) {
    switch(error) {
        case BMI088_ERROR_NO_ERROR: return "NO_ERROR";
        case BMI088_ERROR_ACC_PWR_CTRL: return "ACC_PWR_CTRL_ERROR";
        case BMI088_ERROR_ACC_PWR_CONF: return "ACC_PWR_CONF_ERROR";
        case BMI088_ERROR_ACC_CONF: return "ACC_CONF_ERROR";
        case BMI088_ERROR_ACC_SELF_TEST: return "ACC_SELF_TEST_ERROR";
        case BMI088_ERROR_ACC_RANGE: return "ACC_RANGE_ERROR";
        case BMI088_ERROR_INT1_IO_CTRL: return "INT1_IO_CTRL_ERROR";
        case BMI088_ERROR_INT_MAP_DATA: return "INT_MAP_DATA_ERROR";
        case BMI088_ERROR_GYRO_RANGE: return "GYRO_RANGE_ERROR";
        case BMI088_ERROR_GYRO_BANDWIDTH: return "GYRO_BANDWIDTH_ERROR";
        case BMI088_ERROR_GYRO_LPM1: return "GYRO_LPM1_ERROR";
        case BMI088_ERROR_GYRO_CTRL: return "GYRO_CTRL_ERROR";
        case BMI088_ERROR_GYRO_INT3_INT4_IO_CONF: return "GYRO_INT3_INT4_IO_CONF_ERROR";
        case BMI088_ERROR_GYRO_INT3_INT4_IO_MAP: return "GYRO_INT3_INT4_IO_MAP_ERROR";
        case BMI088_ERROR_SELF_TEST_ACCEL: return "SELF_TEST_ACCEL_ERROR";
        case BMI088_ERROR_SELF_TEST_GYRO: return "SELF_TEST_GYRO_ERROR";
        case BMI088_ERROR_NO_SENSOR: return "NO_SENSOR";
        default: return "UNKNOWN";
    }
}

/**
 * @brief 获取 BMI088 最近一次初始化错误码
 */
Bmi088Error bmi088_get_init_error(void) {
    return s_bmi088_init_error;
}

/**
 * @brief 获取 BMI088 温度
 */
float bmi088_get_temp(void) {
    if(!s_bmi088_is_initialized) {
        return 0.0f;
    }

    return s_bmi088_temp;
}

ImuStatus bmi088_get_attitude_debug(Bmi088AttitudeDebug* debug) {
    const ImuAttitude* attitude = &s_bmi088_attitude;

    if(debug == 0) {
        return IMU_STATUS_INVALID_PARAM;
    }

    if(!s_bmi088_is_initialized) {
        return IMU_STATUS_NOT_INITIALIZE;
    }

    memset(debug, 0, sizeof(Bmi088AttitudeDebug));
    debug->temperature = s_bmi088_temp;

    if(!s_bmi088_attitude_enabled) {
        return IMU_STATUS_UNSUPPORTED;
    }

    debug->gyro_temp_ref = attitude->gyro_temp_ref;
    debug->gyro_bias = attitude->gyro_bias;
    debug->gyro_corrected = attitude->gyro_filtered;
    debug->gyro_temp_comp = bmi088_calc_gyro_temp_comp();
    debug->gyro_z_temp_intercept = attitude->gyro_z_temp_intercept;
    debug->gyro_z_bias_effective = attitude->gyro_z_bias_effective;
    debug->gyro_temp_coeff.x = attitude->config.gyro_x_temp_coeff;
    debug->gyro_temp_coeff.y = attitude->config.gyro_y_temp_coeff;
    debug->gyro_temp_coeff.z = attitude->config.gyro_z_temp_coeff;
    debug->zru_enabled = attitude->zru_enabled;
    debug->zru_active = attitude->zru_active;

    return IMU_STATUS_OK;
}

ImuStatus bmi088_set_zru_enabled(bool enabled) {
    (void)enabled;

    if(!s_bmi088_is_initialized) {
        return IMU_STATUS_NOT_INITIALIZE;
    }

    if(!s_bmi088_attitude_enabled) {
        return IMU_STATUS_UNSUPPORTED;
    }

    s_bmi088_attitude.zru_enabled = false;
    s_bmi088_attitude.zru_active = false;
    s_bmi088_attitude.zru_static_time_us = 0U;
    return IMU_STATUS_OK;
}

bool bmi088_is_zru_enabled(void) {
    if(!s_bmi088_is_initialized || !s_bmi088_attitude_enabled) {
        return false;
    }

    return false;
}

/**
 * @brief BMI088 EXTI 回调转发
 */
void bmi088_exti_callback(uint16_t gpio_pin) {
    if(gpio_pin == s_bmi088_gyro_int_pin) {
        bmi088_notify_gyro_data_ready();
    }
    else if(gpio_pin == s_bmi088_accel_int_pin) {
        bmi088_notify_accel_data_ready();
    }
}

/**
 * @brief BMI088 SPI DMA 完成回调转发
 */
void bmi088_spi_txrx_cplt_callback(void* spi_handle) {
    bmi088_spi_txrx_complete(spi_handle);
}

/**
 * @brief BMI088 SPI 错误回调转发
 */
void bmi088_spi_error_callback(void* spi_handle) {
    bmi088_spi_error(spi_handle);
}

// ! ========================= 私 有 函 数 实 现 ========================= ! //

/**
 * @brief 初始化 BMI088 具体 IMU 实例（非阻塞）
 */
static ImuStatus bmi088_init_async(const void* config) {
    return bmi088_init_common(config, true);
}

/**
 * @brief 初始化 BMI088 具体 IMU 实例（阻塞）
 */
static ImuStatus bmi088_init_blocking(const void* config) {
    return bmi088_init_common(config, false);
}

/**
 * @brief 初始化 BMI088 具体 IMU 实例
 */
static ImuStatus bmi088_init_common(const void* config, bool require_async_ops) {
    const Bmi088Config* bmi088_config = (const Bmi088Config*)config;

    if(!bmi088_config_is_valid(bmi088_config, require_async_ops)) {
        return IMU_STATUS_INVALID_PARAM;
    }

    s_bmi088_ops = bmi088_config->ops;
    s_bmi088_accel_sen = bmi088_config->accel_sen;
    s_bmi088_gyro_sen = bmi088_config->gyro_sen;
    s_bmi088_accel_int_pin = bmi088_config->accel_int_pin;
    s_bmi088_gyro_int_pin = bmi088_config->gyro_int_pin;
    s_bmi088_init_error = bmi088_device_init();
    bmi088_async_init();

    s_bmi088_acc = (ImuAcc){ 0.0f, 0.0f, 0.0f };
    s_bmi088_gyro = (ImuGyro){ 0.0f, 0.0f, 0.0f };
    s_bmi088_angle = (ImuAngle){ 0.0f, 0.0f, 0.0f };
    s_bmi088_sample = (ImuSample){ 0 };
    s_bmi088_temp = 0.0f;
    s_bmi088_is_initialized = (s_bmi088_init_error == BMI088_ERROR_NO_ERROR);

    if(!s_bmi088_is_initialized) {
        return IMU_STATUS_ERROR;
    }

    bmi088_attitude_init(&bmi088_config->attitude);
    return IMU_STATUS_OK;
}

/**
 * @brief 更新 BMI088 具体 IMU 实例缓存
 */
static ImuStatus bmi088_update(void) {
    float raw_acc[3] = { 0.0f };
    float raw_gyro[3] = { 0.0f };
    uint8_t sample_flags = s_bmi088_sample.flags &
        (IMU_SAMPLE_ACC_VALID | IMU_SAMPLE_GYRO_VALID | IMU_SAMPLE_TEMP_VALID);
    uint32_t now_us = 0U;
    bool updated = false;

    if(!s_bmi088_is_initialized) {
        return IMU_STATUS_NOT_INITIALIZE;
    }

    (void)bmi088_async_poll();
    now_us = bmi088_now_us();

    if(bmi088_async_get_gyro(raw_gyro)) {
        s_bmi088_gyro = bmi088_make_gyro(raw_gyro);
        s_bmi088_sample.gyro = s_bmi088_gyro;
        s_bmi088_sample.gyro_timestamp_us = now_us;
        sample_flags |= IMU_SAMPLE_GYRO_NEW | IMU_SAMPLE_GYRO_VALID;
        updated = true;
    }

    if(bmi088_async_get_accel(raw_acc)) {
        if(bmi088_acc_sample_is_reasonable(raw_acc)) {
            s_bmi088_acc = bmi088_make_acc(raw_acc);
            s_bmi088_sample.acc = s_bmi088_acc;
            s_bmi088_sample.acc_timestamp_us = now_us;
            sample_flags |= IMU_SAMPLE_ACC_NEW | IMU_SAMPLE_ACC_VALID;
            updated = true;
        }
    }

    bmi088_update_temp_cache(now_us, &sample_flags);

    if(!updated) {
        return IMU_STATUS_NOT_READY;
    }

    s_bmi088_sample.flags = sample_flags;
    bmi088_attitude_update();
    return IMU_STATUS_OK;
}

/**
 * @brief 以阻塞读取方式更新 BMI088 具体 IMU 实例缓存
 */
static ImuStatus bmi088_blocking_update(void) {
    float raw_acc[3] = { 0.0f };
    float raw_gyro[3] = { 0.0f };
    uint32_t now_us = 0U;

    if(!s_bmi088_is_initialized) {
        return IMU_STATUS_NOT_INITIALIZE;
    }

    bmi088_read_gyro_raw(raw_gyro);
    bmi088_read_accel_raw(raw_acc);

    s_bmi088_gyro = bmi088_make_gyro(raw_gyro);
    s_bmi088_sample.gyro = s_bmi088_gyro;
    now_us = bmi088_now_us();
    s_bmi088_sample.gyro_timestamp_us = now_us;
    s_bmi088_sample.flags = IMU_SAMPLE_GYRO_NEW | IMU_SAMPLE_GYRO_VALID |
        (s_bmi088_sample.flags & IMU_SAMPLE_TEMP_VALID);
    if(bmi088_acc_sample_is_reasonable(raw_acc)) {
        s_bmi088_acc = bmi088_make_acc(raw_acc);
        s_bmi088_sample.acc = s_bmi088_acc;
        s_bmi088_sample.acc_timestamp_us = now_us;
        s_bmi088_sample.flags |= IMU_SAMPLE_ACC_NEW | IMU_SAMPLE_ACC_VALID;
    }
    bmi088_update_temp_cache(now_us, &s_bmi088_sample.flags);
    bmi088_attitude_update();
    return IMU_STATUS_OK;
}

/**
 * @brief 获取 BMI088 最近一次缓存的加速度
 */
static ImuAcc bmi088_get_acc(void) {
    return s_bmi088_acc;
}

/**
 * @brief 获取 BMI088 最近一次缓存的角速度
 */
static ImuGyro bmi088_get_gyro(void) {
    return s_bmi088_gyro;
}

static ImuGyro bmi088_get_gyro_bias(void) {
    ImuGyro gyro_bias = { 0.0f, 0.0f, 0.0f };

    if(!s_bmi088_attitude_enabled) {
        return gyro_bias;
    }

    (void)imu_attitude_get_gyro_bias(&s_bmi088_attitude, &gyro_bias);
    return gyro_bias;
}

static ImuGyro bmi088_get_gyro_corrected(void) {
    ImuGyro gyro_corrected = { 0.0f, 0.0f, 0.0f };

    if(!s_bmi088_attitude_enabled) {
        return s_bmi088_gyro;
    }

    (void)imu_attitude_get_gyro_corrected(&s_bmi088_attitude, &gyro_corrected);
    return gyro_corrected;
}

/**
 * @brief 获取 BMI088 最近一次缓存的姿态角
 */
static ImuAngle bmi088_get_angle(void) {
    return s_bmi088_angle;
}

static ImuStatus bmi088_get_sample(ImuSample* sample) {
    uint8_t new_flags = 0U;

    if(sample == 0) {
        return IMU_STATUS_INVALID_PARAM;
    }

    if(!s_bmi088_is_initialized) {
        return IMU_STATUS_NOT_INITIALIZE;
    }

    new_flags = s_bmi088_sample.flags &
        (IMU_SAMPLE_ACC_NEW | IMU_SAMPLE_GYRO_NEW | IMU_SAMPLE_TEMP_NEW);
    if(new_flags == IMU_SAMPLE_NONE) {
        return IMU_STATUS_NOT_READY;
    }

    *sample = s_bmi088_sample;
    s_bmi088_sample.flags &= (IMU_SAMPLE_ACC_VALID | IMU_SAMPLE_GYRO_VALID | IMU_SAMPLE_TEMP_VALID);
    return IMU_STATUS_OK;
}

/**
 * @brief 将 IMU 状态码转换为常量字符串
 */
static const char* bmi088_status_str(ImuStatus status) {
    switch(status) {
        case IMU_STATUS_OK: return "OK";
        case IMU_STATUS_ERROR: return "ERROR";
        case IMU_STATUS_INVALID_PARAM: return "INVALID_PARAM";
        case IMU_STATUS_NO_INSTANCE: return "NO_INSTANCE";
        case IMU_STATUS_NOT_INITIALIZE: return "NOT_INITIALIZE";
        case IMU_STATUS_NOT_READY: return "NOT_READY";
        case IMU_STATUS_UNSUPPORTED: return "UNSUPPORTED";
        default: return "UNKNOWN";
    }
}

/**
 * @brief 初始化 BMI088 设备
 */
static Bmi088Error bmi088_device_init(void) {
    Bmi088Error error = BMI088_ERROR_NO_ERROR;

    bmi088_gpio_init();
    bmi088_com_init();
    bmi088_async_init();

    error = (Bmi088Error)(error | bmi088_accel_init());
    error = (Bmi088Error)(error | bmi088_gyro_init());
    return error;
}

/**
 * @brief 初始化 BMI088 加速度计
 */
static Bmi088Error bmi088_accel_init(void) {
    uint8_t res = 0U;

    bmi088_accel_read_single_reg(BMI088_ACC_CHIP_ID, &res);
    bmi088_delay_us(BMI088_COM_WAIT_SENSOR_TIME);
    bmi088_accel_read_single_reg(BMI088_ACC_CHIP_ID, &res);
    bmi088_delay_us(BMI088_COM_WAIT_SENSOR_TIME);

    bmi088_accel_write_single_reg(BMI088_ACC_SOFTRESET, BMI088_ACC_SOFTRESET_VALUE);
    bmi088_delay_ms(BMI088_LONG_DELAY_TIME);

    bmi088_accel_read_single_reg(BMI088_ACC_CHIP_ID, &res);
    bmi088_delay_us(BMI088_COM_WAIT_SENSOR_TIME);
    bmi088_accel_read_single_reg(BMI088_ACC_CHIP_ID, &res);
    bmi088_delay_us(BMI088_COM_WAIT_SENSOR_TIME);

    if(res != BMI088_ACC_CHIP_ID_VALUE) {
        return BMI088_ERROR_NO_SENSOR;
    }

    for(uint8_t write_reg_num = 0U; write_reg_num < BMI088_WRITE_ACCEL_REG_NUM; write_reg_num++) {
        bmi088_accel_write_single_reg(
            s_bmi088_accel_reg_init[write_reg_num][0],
            s_bmi088_accel_reg_init[write_reg_num][1]);
        bmi088_delay_us(BMI088_COM_WAIT_SENSOR_TIME);

        bmi088_accel_read_single_reg(s_bmi088_accel_reg_init[write_reg_num][0], &res);
        bmi088_delay_us(BMI088_COM_WAIT_SENSOR_TIME);

        if(res != s_bmi088_accel_reg_init[write_reg_num][1]) {
            return (Bmi088Error)s_bmi088_accel_reg_init[write_reg_num][2];
        }
    }

    return BMI088_ERROR_NO_ERROR;
}

/**
 * @brief 初始化 BMI088 陀螺仪
 */
static Bmi088Error bmi088_gyro_init(void) {
    uint8_t res = 0U;

    bmi088_gyro_read_single_reg(BMI088_GYRO_CHIP_ID, &res);
    bmi088_delay_us(BMI088_COM_WAIT_SENSOR_TIME);
    bmi088_gyro_read_single_reg(BMI088_GYRO_CHIP_ID, &res);
    bmi088_delay_us(BMI088_COM_WAIT_SENSOR_TIME);

    bmi088_gyro_write_single_reg(BMI088_GYRO_SOFTRESET, BMI088_GYRO_SOFTRESET_VALUE);
    bmi088_delay_ms(BMI088_LONG_DELAY_TIME);

    bmi088_gyro_read_single_reg(BMI088_GYRO_CHIP_ID, &res);
    bmi088_delay_us(BMI088_COM_WAIT_SENSOR_TIME);
    bmi088_gyro_read_single_reg(BMI088_GYRO_CHIP_ID, &res);
    bmi088_delay_us(BMI088_COM_WAIT_SENSOR_TIME);

    if(res != BMI088_GYRO_CHIP_ID_VALUE) {
        return BMI088_ERROR_NO_SENSOR;
    }

    for(uint8_t write_reg_num = 0U; write_reg_num < BMI088_WRITE_GYRO_REG_NUM; write_reg_num++) {
        bmi088_gyro_write_single_reg(
            s_bmi088_gyro_reg_init[write_reg_num][0],
            s_bmi088_gyro_reg_init[write_reg_num][1]);
        bmi088_delay_us(BMI088_COM_WAIT_SENSOR_TIME);

        bmi088_gyro_read_single_reg(s_bmi088_gyro_reg_init[write_reg_num][0], &res);
        bmi088_delay_us(BMI088_COM_WAIT_SENSOR_TIME);

        if(res != s_bmi088_gyro_reg_init[write_reg_num][1]) {
            return (Bmi088Error)s_bmi088_gyro_reg_init[write_reg_num][2];
        }
    }

    return BMI088_ERROR_NO_ERROR;
}

/**
 * @brief 阻塞读取 BMI088 陀螺仪
 */
static void bmi088_read_gyro_raw(float gyro[3]) {
    uint8_t buf[6] = { 0U };
    int16_t raw_value = 0;

    if(gyro == 0) {
        return;
    }

    bmi088_gyro_cs_low();
    bmi088_read_write_byte(BMI088_GYRO_X_L | 0x80U);

    for(uint8_t i = 0U; i < sizeof(buf); i++) {
        buf[i] = bmi088_read_write_byte(BMI088_SPI_DUMMY_BYTE);
    }

    bmi088_gyro_cs_high();

    raw_value = (int16_t)(((uint16_t)buf[1] << 8) | buf[0]);
    gyro[0] = raw_value * s_bmi088_gyro_sen;

    raw_value = (int16_t)(((uint16_t)buf[3] << 8) | buf[2]);
    gyro[1] = raw_value * s_bmi088_gyro_sen;

    raw_value = (int16_t)(((uint16_t)buf[5] << 8) | buf[4]);
    gyro[2] = raw_value * s_bmi088_gyro_sen;
}

/**
 * @brief 阻塞读取 BMI088 加速度计
 */
static void bmi088_read_accel_raw(float accel[3]) {
    uint8_t buf[6] = { 0U };
    int16_t raw_value = 0;

    if(accel == 0) {
        return;
    }

    bmi088_accel_read_burst(BMI088_ACCEL_XOUT_L, buf, sizeof(buf));

    raw_value = (int16_t)(((uint16_t)buf[1] << 8) | buf[0]);
    accel[0] = raw_value * s_bmi088_accel_sen;

    raw_value = (int16_t)(((uint16_t)buf[3] << 8) | buf[2]);
    accel[1] = raw_value * s_bmi088_accel_sen;

    raw_value = (int16_t)(((uint16_t)buf[5] << 8) | buf[4]);
    accel[2] = raw_value * s_bmi088_accel_sen;
}

/**
 * @brief 阻塞读取 BMI088 温度
 */
static void bmi088_read_temp_raw(float* temperature) {
    uint8_t buf[2] = { 0U };
    int16_t raw_value = 0;

    if(temperature == 0) {
        return;
    }

    bmi088_accel_read_burst(BMI088_TEMP_M, buf, sizeof(buf));

    raw_value = (int16_t)((buf[0] << 3) | (buf[1] >> 5));
    if(raw_value > 1023) {
        raw_value -= 2048;
    }

    *temperature = raw_value * BMI088_TEMP_FACTOR + BMI088_TEMP_OFFSET;
}

/**
 * @brief 初始化 BMI088 异步状态机
 */
static void bmi088_async_init(void) {
    s_bmi088_dma_state = BMI088_DMA_IDLE;
    s_bmi088_async_next = BMI088_ASYNC_NEXT_GYRO;
    s_bmi088_gyro_pending = true;
    s_bmi088_accel_pending = true;
    s_bmi088_gyro_ready = false;
    s_bmi088_accel_ready = false;
    memset(s_bmi088_tx, 0, sizeof(s_bmi088_tx));
    memset(s_bmi088_rx, 0, sizeof(s_bmi088_rx));
    memset(s_bmi088_gyro_dma, 0, sizeof(s_bmi088_gyro_dma));
    memset(s_bmi088_accel_dma, 0, sizeof(s_bmi088_accel_dma));
    bmi088_release_all_cs();
}

/**
 * @brief 标记陀螺仪数据就绪
 */
static void bmi088_notify_gyro_data_ready(void) {
    s_bmi088_gyro_pending = true;
}

/**
 * @brief 标记加速度计数据就绪
 */
static void bmi088_notify_accel_data_ready(void) {
    s_bmi088_accel_pending = true;
}

/**
 * @brief 轮询并启动 BMI088 DMA 读取
 */
static bool bmi088_async_poll(void) {
    uint32_t now_us = 0U;
    bool prefer_gyro = false;

    if(s_bmi088_dma_state != BMI088_DMA_IDLE) {
        return false;
    }

    now_us = bmi088_now_us();
    if(!s_bmi088_gyro_pending &&
        (s_bmi088_sample.gyro_timestamp_us == 0U ||
            (now_us - s_bmi088_sample.gyro_timestamp_us) > BMI088_GYRO_STALE_TIMEOUT_US)) {
        s_bmi088_gyro_pending = true;
    }

    if(!s_bmi088_accel_pending &&
        (s_bmi088_sample.acc_timestamp_us == 0U ||
            (now_us - s_bmi088_sample.acc_timestamp_us) > BMI088_ACCEL_STALE_TIMEOUT_US)) {
        s_bmi088_accel_pending = true;
    }

    prefer_gyro = (s_bmi088_async_next == BMI088_ASYNC_NEXT_GYRO);

    if(prefer_gyro) {
        if(s_bmi088_gyro_pending) {
            s_bmi088_gyro_pending = false;
            if(bmi088_start_gyro_dma()) {
                s_bmi088_async_next = BMI088_ASYNC_NEXT_ACCEL;
                return true;
            }

            s_bmi088_gyro_pending = true;
        }

        if(s_bmi088_accel_pending) {
            s_bmi088_accel_pending = false;
            if(bmi088_start_accel_dma()) {
                s_bmi088_async_next = BMI088_ASYNC_NEXT_GYRO;
                return true;
            }

            s_bmi088_accel_pending = true;
        }
    }
    else {
        if(s_bmi088_accel_pending) {
            s_bmi088_accel_pending = false;
            if(bmi088_start_accel_dma()) {
                s_bmi088_async_next = BMI088_ASYNC_NEXT_GYRO;
                return true;
            }

            s_bmi088_accel_pending = true;
        }

        if(s_bmi088_gyro_pending) {
            s_bmi088_gyro_pending = false;
            if(bmi088_start_gyro_dma()) {
                s_bmi088_async_next = BMI088_ASYNC_NEXT_ACCEL;
                return true;
            }

            s_bmi088_gyro_pending = true;
        }
    }

    return false;
}

/**
 * @brief 获取最近一次 DMA 陀螺仪数据
 */
static bool bmi088_async_get_gyro(float gyro[3]) {
    if(gyro == 0 || !s_bmi088_gyro_ready) {
        return false;
    }

    bmi088_copy_vector3(gyro, s_bmi088_gyro_dma);
    s_bmi088_gyro_ready = false;
    return true;
}

/**
 * @brief 获取最近一次 DMA 加速度数据
 */
static bool bmi088_async_get_accel(float accel[3]) {
    if(accel == 0 || !s_bmi088_accel_ready) {
        return false;
    }

    bmi088_copy_vector3(accel, s_bmi088_accel_dma);
    s_bmi088_accel_ready = false;
    return true;
}

/**
 * @brief 处理 BMI088 SPI DMA 完成中断
 */
static void bmi088_spi_txrx_complete(void* spi_handle) {
    if(s_bmi088_ops == 0) {
        return;
    }

    if(spi_handle != bmi088_get_spi_handle()) {
        return;
    }

    if(s_bmi088_dma_state == BMI088_DMA_GYRO) {
        bmi088_gyro_cs_high();
        bmi088_dma_maintain_after_finish(BMI088_DMA_GYRO_FRAME_LEN);
        bmi088_parse_gyro_dma_buffer();
        s_bmi088_gyro_ready = true;
    }
    else if(s_bmi088_dma_state == BMI088_DMA_ACCEL) {
        bmi088_accel_cs_high();
        bmi088_dma_maintain_after_finish(BMI088_DMA_ACCEL_FRAME_LEN);
        bmi088_parse_accel_dma_buffer();
        s_bmi088_accel_ready = true;
    }

    s_bmi088_dma_state = BMI088_DMA_IDLE;
}

/**
 * @brief 处理 BMI088 SPI 错误中断
 */
static void bmi088_spi_error(void* spi_handle) {
    if(s_bmi088_ops == 0) {
        return;
    }

    if(spi_handle != bmi088_get_spi_handle()) {
        return;
    }

    bmi088_release_all_cs();
    s_bmi088_dma_state = BMI088_DMA_IDLE;
}

static uint32_t bmi088_now_ms(void) {
    return s_bmi088_ops->now_ms();
}

static uint32_t bmi088_now_us(void) {
    if(s_bmi088_ops->now_us != 0) {
        return s_bmi088_ops->now_us();
    }

    return bmi088_now_ms() * 1000U;
}

static bool bmi088_config_is_valid(const Bmi088Config* config, bool require_async_ops) {
    const Bmi088PortOps* ops = 0;

    if(config == 0 || config->ops == 0) {
        return false;
    }

    ops = config->ops;
    if(ops->accel_cs_low == 0 || ops->accel_cs_high == 0 ||
        ops->gyro_cs_low == 0 || ops->gyro_cs_high == 0 ||
        ops->read_write_byte == 0 || ops->now_ms == 0 ||
        ops->now_us == 0 || ops->delay_ms == 0 || ops->delay_us == 0) {
        return false;
    }

    if(require_async_ops &&
        (ops->transmit_receive_dma == 0 || ops->get_spi_handle == 0)) {
        return false;
    }

    if(config->accel_sen <= 0.0f || config->gyro_sen <= 0.0f) {
        return false;
    }

    return true;
}

static void bmi088_attitude_init(const ImuAttitudeConfig* config) {
    if(config == 0 || config->mode == IMU_ATTITUDE_NONE) {
        s_bmi088_attitude_enabled = false;
        return;
    }

    s_bmi088_attitude_enabled =
        (imu_attitude_init(&s_bmi088_attitude, config) == IMU_ATTITUDE_STATUS_OK);
}

static void bmi088_attitude_update(void) {
    ImuAttitudeStatus status = IMU_ATTITUDE_STATUS_OK;

    if(!s_bmi088_attitude_enabled) {
        return;
    }

    if((s_bmi088_sample.flags & IMU_SAMPLE_GYRO_NEW) == 0U) {
        return;
    }

    status = imu_attitude_update(&s_bmi088_attitude, &s_bmi088_sample);
    if(status == IMU_ATTITUDE_STATUS_OK ||
        (status == IMU_ATTITUDE_STATUS_CALIBRATING && s_bmi088_attitude.has_angle != 0U)) {
        (void)imu_attitude_get_angle(&s_bmi088_attitude, &s_bmi088_angle);
    }
}

static void bmi088_gpio_init(void) {
    bmi088_accel_cs_high();
    bmi088_gyro_cs_high();
    bmi088_delay_ms(1U);
}

/**
 * @brief 初始化 BMI088 通信接口
 */
static void bmi088_com_init(void) {}

/**
 * @brief 毫秒级阻塞延时
 */
static void bmi088_delay_ms(uint16_t ms) {
    if(s_bmi088_ops != 0 && s_bmi088_ops->delay_ms != 0) {
        s_bmi088_ops->delay_ms(ms);
    }
}

/**
 * @brief 微秒级阻塞延时
 */
static void bmi088_delay_us(uint16_t us) {
    if(s_bmi088_ops != 0 && s_bmi088_ops->delay_us != 0) {
        s_bmi088_ops->delay_us(us);
    }
}

/**
 * @brief 拉低 accel 片选
 */
static void bmi088_accel_cs_low(void) {
    s_bmi088_ops->accel_cs_low();
}

/**
 * @brief 拉高 accel 片选
 */
static void bmi088_accel_cs_high(void) {
    s_bmi088_ops->accel_cs_high();
}

/**
 * @brief 拉低 gyro 片选
 */
static void bmi088_gyro_cs_low(void) {
    s_bmi088_ops->gyro_cs_low();
}

/**
 * @brief 拉高 gyro 片选
 */
static void bmi088_gyro_cs_high(void) {
    s_bmi088_ops->gyro_cs_high();
}

/**
 * @brief SPI 单字节收发
 */
static uint8_t bmi088_read_write_byte(uint8_t tx_data) {
    return s_bmi088_ops->read_write_byte(tx_data);
}

/**
 * @brief 获取 BMI088 当前使用的 SPI 句柄
 */
static void* bmi088_get_spi_handle(void) {
    return s_bmi088_ops->get_spi_handle();
}

/**
 * @brief 启动 BMI088 SPI DMA 收发
 */
static bool bmi088_spi_transmit_receive_dma(uint8_t* tx_data, uint8_t* rx_data, uint16_t len) {
    return s_bmi088_ops->transmit_receive_dma(tx_data, rx_data, len);
}

/**
 * @brief 向 BMI088 写单寄存器
 */
static void bmi088_write_single_reg(uint8_t reg, uint8_t data) {
    bmi088_read_write_byte(reg);
    bmi088_read_write_byte(data);
}

/**
 * @brief 从 BMI088 读单寄存器
 */
static void bmi088_read_single_reg(uint8_t reg, uint8_t* return_data) {
    bmi088_read_write_byte(reg | 0x80U);
    *return_data = bmi088_read_write_byte(BMI088_SPI_DUMMY_BYTE);
}

/**
 * @brief 向 BMI088 accel 写单寄存器
 */
static void bmi088_accel_write_single_reg(uint8_t reg, uint8_t data) {
    bmi088_accel_cs_low();
    bmi088_write_single_reg(reg, data);
    bmi088_accel_cs_high();
}

/**
 * @brief 从 BMI088 accel 读单寄存器
 */
static void bmi088_accel_read_single_reg(uint8_t reg, uint8_t* data) {
    bmi088_accel_cs_low();
    bmi088_read_write_byte(reg | 0x80U);
    bmi088_read_write_byte(BMI088_SPI_DUMMY_BYTE);
    *data = bmi088_read_write_byte(BMI088_SPI_DUMMY_BYTE);
    bmi088_accel_cs_high();
}

/**
 * @brief 从 BMI088 accel 连续读寄存器
 */
static void bmi088_accel_read_burst(uint8_t reg, uint8_t* buf, uint8_t len) {
    bmi088_accel_cs_low();
    bmi088_read_write_byte(reg | 0x80U);
    bmi088_read_write_byte(BMI088_SPI_DUMMY_BYTE);

    while(len != 0U) {
        *buf = bmi088_read_write_byte(BMI088_SPI_DUMMY_BYTE);
        buf++;
        len--;
    }

    bmi088_accel_cs_high();
}

/**
 * @brief 向 BMI088 gyro 写单寄存器
 */
static void bmi088_gyro_write_single_reg(uint8_t reg, uint8_t data) {
    bmi088_gyro_cs_low();
    bmi088_write_single_reg(reg, data);
    bmi088_gyro_cs_high();
}

/**
 * @brief 从 BMI088 gyro 读单寄存器
 */
static void bmi088_gyro_read_single_reg(uint8_t reg, uint8_t* data) {
    bmi088_gyro_cs_low();
    bmi088_read_single_reg(reg, data);
    bmi088_gyro_cs_high();
}

/**
 * @brief 释放所有片选
 */
static void bmi088_release_all_cs(void) {
    bmi088_accel_cs_high();
    bmi088_gyro_cs_high();
}

/**
 * @brief 启动 gyro DMA 读取
 */
static bool bmi088_start_gyro_dma(void) {
    if(s_bmi088_dma_state != BMI088_DMA_IDLE) {
        return false;
    }

    s_bmi088_dma_state = BMI088_DMA_GYRO;
    bmi088_dma_prepare_txrx(BMI088_DMA_GYRO_FRAME_LEN);
    s_bmi088_tx[0] = BMI088_GYRO_X_L | 0x80U;
    bmi088_dma_maintain_before_start(BMI088_DMA_GYRO_FRAME_LEN);
    bmi088_gyro_cs_low();

    if(!bmi088_spi_transmit_receive_dma(s_bmi088_tx, s_bmi088_rx, BMI088_DMA_GYRO_FRAME_LEN)) {
        bmi088_gyro_cs_high();
        s_bmi088_dma_state = BMI088_DMA_IDLE;
        return false;
    }

    return true;
}

/**
 * @brief 启动 accel DMA 读取
 */
static bool bmi088_start_accel_dma(void) {
    if(s_bmi088_dma_state != BMI088_DMA_IDLE) {
        return false;
    }

    s_bmi088_dma_state = BMI088_DMA_ACCEL;
    bmi088_dma_prepare_txrx(BMI088_DMA_ACCEL_FRAME_LEN);
    s_bmi088_tx[0] = BMI088_ACCEL_XOUT_L | 0x80U;
    bmi088_dma_maintain_before_start(BMI088_DMA_ACCEL_FRAME_LEN);
    bmi088_accel_cs_low();

    if(!bmi088_spi_transmit_receive_dma(s_bmi088_tx, s_bmi088_rx, BMI088_DMA_ACCEL_FRAME_LEN)) {
        bmi088_accel_cs_high();
        s_bmi088_dma_state = BMI088_DMA_IDLE;
        return false;
    }

    return true;
}

/**
 * @brief 解析 gyro DMA 缓冲区
 */
static void bmi088_parse_gyro_dma_buffer(void) {
    int16_t raw_value = 0;

    raw_value = (int16_t)(((uint16_t)s_bmi088_rx[2] << 8) | s_bmi088_rx[1]);
    s_bmi088_gyro_dma[0] = raw_value * s_bmi088_gyro_sen;

    raw_value = (int16_t)(((uint16_t)s_bmi088_rx[4] << 8) | s_bmi088_rx[3]);
    s_bmi088_gyro_dma[1] = raw_value * s_bmi088_gyro_sen;

    raw_value = (int16_t)(((uint16_t)s_bmi088_rx[6] << 8) | s_bmi088_rx[5]);
    s_bmi088_gyro_dma[2] = raw_value * s_bmi088_gyro_sen;
}

/**
 * @brief 解析 accel DMA 缓冲区
 */
static void bmi088_parse_accel_dma_buffer(void) {
    int16_t raw_value = 0;

    raw_value = (int16_t)(((uint16_t)s_bmi088_rx[3] << 8) | s_bmi088_rx[2]);
    s_bmi088_accel_dma[0] = raw_value * s_bmi088_accel_sen;

    raw_value = (int16_t)(((uint16_t)s_bmi088_rx[5] << 8) | s_bmi088_rx[4]);
    s_bmi088_accel_dma[1] = raw_value * s_bmi088_accel_sen;

    raw_value = (int16_t)(((uint16_t)s_bmi088_rx[7] << 8) | s_bmi088_rx[6]);
    s_bmi088_accel_dma[2] = raw_value * s_bmi088_accel_sen;
}

/**
 * @brief 拷贝三轴数据
 */
static void bmi088_copy_vector3(float dst[3], const float src[3]) {
    dst[0] = src[0];
    dst[1] = src[1];
    dst[2] = src[2];
}

/**
 * @brief 准备 DMA 收发缓冲区
 */
static void bmi088_dma_prepare_txrx(uint16_t len) {
    memset(s_bmi088_tx, BMI088_SPI_DUMMY_BYTE, len);
    memset(s_bmi088_rx, 0, len);
}

/**
 * @brief DMA 启动前维护 Cache
 */
static void bmi088_dma_maintain_before_start(uint16_t len) {
    if(s_bmi088_ops != 0 && s_bmi088_ops->cache_clean != 0) {
        s_bmi088_ops->cache_clean(s_bmi088_tx, len);
    }

    if(s_bmi088_ops != 0 && s_bmi088_ops->cache_invalidate != 0) {
        s_bmi088_ops->cache_invalidate(s_bmi088_rx, len);
    }
}

/**
 * @brief DMA 结束后维护 Cache
 */
static void bmi088_dma_maintain_after_finish(uint16_t len) {
    if(s_bmi088_ops != 0 && s_bmi088_ops->cache_invalidate != 0) {
        s_bmi088_ops->cache_invalidate(s_bmi088_rx, len);
        return;
    }

    (void)len;
}

static void bmi088_update_temp_cache(uint32_t now_us, uint8_t* sample_flags) {
    if(sample_flags == 0) {
        return;
    }

    if(now_us == 0U) {
        now_us = bmi088_now_us();
    }

    if(s_bmi088_sample.temp_timestamp_us != 0U &&
        (now_us - s_bmi088_sample.temp_timestamp_us) < BMI088_TEMP_UPDATE_PERIOD_US) {
        return;
    }

    bmi088_read_temp_raw(&s_bmi088_temp);
    s_bmi088_sample.temperature = s_bmi088_temp;
    s_bmi088_sample.temp_timestamp_us = now_us;
    *sample_flags |= IMU_SAMPLE_TEMP_NEW | IMU_SAMPLE_TEMP_VALID;
}

static ImuGyro bmi088_calc_gyro_temp_comp(void) {
    ImuGyro gyro_temp_comp = { 0.0f, 0.0f, 0.0f };

    if(!s_bmi088_attitude_enabled || (s_bmi088_sample.flags & IMU_SAMPLE_TEMP_VALID) == 0U) {
        return gyro_temp_comp;
    }

    gyro_temp_comp.x = s_bmi088_attitude.config.gyro_x_temp_coeff * s_bmi088_sample.temperature;
    gyro_temp_comp.y = s_bmi088_attitude.config.gyro_y_temp_coeff * s_bmi088_sample.temperature;
    gyro_temp_comp.z =
        s_bmi088_attitude.gyro_z_bias_effective -
        s_bmi088_attitude.gyro_bias.z;

    return gyro_temp_comp;
}

static float bmi088_acc_norm(const float acc[3]) {
    if(acc == 0) {
        return 0.0f;
    }

    return sqrtf(acc[0] * acc[0] + acc[1] * acc[1] + acc[2] * acc[2]);
}

static bool bmi088_acc_sample_is_reasonable(const float acc[3]) {
    const float norm = bmi088_acc_norm(acc);

    return norm >= BMI088_ACCEL_NORM_MIN_MPS2 &&
        norm <= BMI088_ACCEL_NORM_MAX_MPS2;
}

/**
 * @brief 将原始三轴数组转换为加速度结构体
 */
static ImuAcc bmi088_make_acc(const float acc[3]) {
    ImuAcc result = { 0.0f, 0.0f, 0.0f };

    if(acc == 0) {
        return result;
    }

    result.x = acc[0];
    result.y = acc[1];
    result.z = acc[2];
    return result;
}

/**
 * @brief 将原始三轴数组转换为角速度结构体
 */
static ImuGyro bmi088_make_gyro(const float gyro[3]) {
    ImuGyro result = { 0.0f, 0.0f, 0.0f };

    if(gyro == 0) {
        return result;
    }

    result.x = gyro[0];
    result.y = gyro[1];
    result.z = gyro[2];
    return result;
}
