LHC0821/2026TI-match-ball-system/src/infra/log.c

#include "log.h"

#include <stdarg.h>
#include <stdio.h>

// ! ========================= 变 量 声 明 ========================= ! //

#define LOG_COLOR_RED "\x1b[31m"
#define LOG_COLOR_YELLOW "\x1b[33m"
#define LOG_COLOR_BLUE "\x1b[34m"
#define LOG_COLOR_RESET "\x1b[0m"

static const LogPortOps* s_ops;
static LogLevel s_level = LOG_LEVEL_NONE;
static bool s_enable_color;
static bool s_async_write;
static volatile bool s_write_busy;
static char s_tx_queue[LOG_QUEUE_DEPTH][LOG_BUFFER_SIZE];
static uint32_t s_tx_len_queue[LOG_QUEUE_DEPTH];
static uint32_t s_tx_head;
static uint32_t s_tx_tail;
static uint32_t s_tx_count;

// ! ========================= 私 有 函 数 声 明 ========================= ! //

/**
 * @brief log_vwrite 内部辅助函数
 * @param level 参数值
 * @param color 参数值
 * @param tag 参数值
 * @param format 参数值
 * @param args 参数值
 * @return 状态码
 */
static LogStatus log_vwrite(LogLevel level, const char* color, const char* tag, const char* format, va_list args);
/**
 * @brief log_append_text 内部辅助函数
 * @param buffer 参数值
 * @param size 参数值
 * @param pos 参数值
 * @param text 参数值
 * @return 返回值
 */
static uint32_t log_append_text(char* buffer, uint32_t size, uint32_t pos, const char* text);
/**
 * @brief log_append_format 内部辅助函数
 * @param buffer 参数值
 * @param size 参数值
 * @param pos 参数值
 * @param format 参数值
 * @return 返回值
 */
static uint32_t log_append_format(char* buffer, uint32_t size, uint32_t pos, const char* format, ...);
/**
 * @brief log_append_u64 内部辅助函数
 * @param buffer 参数值
 * @param size 参数值
 * @param pos 参数值
 * @param value 数值
 * @return 返回值
 */
static uint32_t log_append_u64(char* buffer, uint32_t size, uint32_t pos, unsigned long long value);
/**
 * @brief log_append_i64 内部辅助函数
 * @param buffer 参数值
 * @param size 参数值
 * @param pos 参数值
 * @param value 数值
 * @return 返回值
 */
static uint32_t log_append_i64(char* buffer, uint32_t size, uint32_t pos, long long value);
/**
 * @brief log_append_vofa_value 内部辅助函数
 * @param buffer 参数值
 * @param size 参数值
 * @param pos 参数值
 * @param value 数值
 * @return 返回值
 */
static uint32_t log_append_vofa_value(char* buffer, uint32_t size, uint32_t pos, const LogVofaValue* value);
/**
 * @brief log_start_async_write 内部辅助函数
 * @return 状态码
 */
static LogStatus log_start_async_write(void);
/**
 * @brief log_prepare_tx_buffer 内部辅助函数
 * @param tx_buffer 参数值
 * @return 状态码
 */
static LogStatus log_prepare_tx_buffer(char** tx_buffer);
/**
 * @brief log_commit_tx_buffer 内部辅助函数
 * @param len 数据长度
 * @return 状态码
 */
static LogStatus log_commit_tx_buffer(uint32_t len);

// ! ========================= 接 口 函 数 实 现 ========================= ! //

LogStatus log_init(const LogConfig* config) {
    if(config == 0 || config->ops == 0 || config->ops->write == 0) {
        return LOG_STATUS_INVALID_PARAM;
    }

    s_ops = config->ops;
    s_level = config->level;
    s_enable_color = config->enable_color;
    s_async_write = config->async_write;
    s_write_busy = false;
    s_tx_head = 0u;
    s_tx_tail = 0u;
    s_tx_count = 0u;

    return LOG_STATUS_OK;
}

LogStatus log_set_level(LogLevel level) {
    if(level > LOG_LEVEL_INFO) {
        return LOG_STATUS_INVALID_PARAM;
    }

    s_level = level;
    return LOG_STATUS_OK;
}

void log_write_complete(void) {
    if(s_async_write && s_tx_count > 0u) {
        s_tx_head = (s_tx_head + 1u) % LOG_QUEUE_DEPTH;
        s_tx_count--;
    }

    s_write_busy = false;
    (void)log_start_async_write();
}

LogStatus log_info(const char* format, ...) {
    va_list args;
    LogStatus status;

    va_start(args, format);
    status = log_vwrite(LOG_LEVEL_INFO, LOG_COLOR_BLUE, "[INFO] ", format, args);
    va_end(args);

    return status;
}

LogStatus log_warn(const char* format, ...) {
    va_list args;
    LogStatus status;

    va_start(args, format);
    status = log_vwrite(LOG_LEVEL_WARN, LOG_COLOR_YELLOW, "[WARN] ", format, args);
    va_end(args);

    return status;
}

LogStatus log_error(const char* format, ...) {
    va_list args;
    LogStatus status;

    va_start(args, format);
    status = log_vwrite(LOG_LEVEL_ERROR, LOG_COLOR_RED, "[ERROR] ", format, args);
    va_end(args);

    return status;
}

LogVofaValue log_vofa_value_i64(long long value) {
    LogVofaValue vofa_value;

    vofa_value.type = LOG_VOFA_VALUE_I64;
    vofa_value.data.i64 = value;

    return vofa_value;
}

LogVofaValue log_vofa_value_u64(unsigned long long value) {
    LogVofaValue vofa_value;

    vofa_value.type = LOG_VOFA_VALUE_U64;
    vofa_value.data.u64 = value;

    return vofa_value;
}

LogVofaValue log_vofa_value_f64(double value) {
    LogVofaValue vofa_value;

    vofa_value.type = LOG_VOFA_VALUE_F64;
    vofa_value.data.f64 = value;

    return vofa_value;
}

LogVofaValue log_vofa_value_bool(bool value) {
    LogVofaValue vofa_value;

    vofa_value.type = LOG_VOFA_VALUE_BOOL;
    vofa_value.data.bool_value = value;

    return vofa_value;
}

LogVofaValue log_vofa_value_cstr(const char* value) {
    LogVofaValue vofa_value;

    vofa_value.type = LOG_VOFA_VALUE_CSTR;
    vofa_value.data.cstr = value;

    return vofa_value;
}

LogVofaValue log_vofa_value_ptr(const void* value) {
    LogVofaValue vofa_value;

    vofa_value.type = LOG_VOFA_VALUE_PTR;
    vofa_value.data.ptr = value;

    return vofa_value;
}

LogStatus log_vofa_write(const char* names, uint32_t count, const LogVofaValue* values) {
    LogStatus status;
    char* tx_buffer;
    uint32_t pos = 0u;
    uint32_t i;

    if(names == 0 || values == 0 || count == 0u || count > LOG_VOFA_MAX_ARGS) {
        return LOG_STATUS_INVALID_PARAM;
    }

    if(s_level == LOG_LEVEL_NONE) {
        return LOG_STATUS_OK;
    }

    status = log_prepare_tx_buffer(&tx_buffer);
    if(status != LOG_STATUS_OK) {
        return status;
    }

    pos = log_append_text(tx_buffer, LOG_BUFFER_SIZE, pos, names);
    pos = log_append_text(tx_buffer, LOG_BUFFER_SIZE, pos, ": ");

    for(i = 0u; i < count; i++) {
        if(i > 0u) {
            pos = log_append_text(tx_buffer, LOG_BUFFER_SIZE, pos, ", ");
        }

        pos = log_append_vofa_value(tx_buffer, LOG_BUFFER_SIZE, pos, &values[i]);
    }

    pos = log_append_text(tx_buffer, LOG_BUFFER_SIZE, pos, "\r\n");

    if(pos >= LOG_BUFFER_SIZE) {
        pos = LOG_BUFFER_SIZE - 1u;
    }

    return log_commit_tx_buffer(pos);
}

const char* log_status_str(LogStatus status) {
    switch(status) {
        case LOG_STATUS_OK:
            return "OK";
        case LOG_STATUS_INVALID_PARAM:
            return "INVALID_PARAM";
        case LOG_STATUS_PORT_ERROR:
            return "PORT_ERROR";
        case LOG_STATUS_NOT_INITIALIZED:
            return "NOT_INITIALIZED";
        case LOG_STATUS_BUSY:
            return "BUSY";
        default:
            return "UNKNOWN";
    }
}

// ! ========================= 私 有 函 数 实 现 ========================= ! //

static LogStatus log_vwrite(LogLevel level, const char* color, const char* tag, const char* format, va_list args) {
    int len;
    uint32_t pos = 0u;
    uint32_t remain;
    char* tx_buffer;
    LogStatus status;

    if(format == 0) {
        return LOG_STATUS_INVALID_PARAM;
    }

    if(s_level < level) {
        return LOG_STATUS_OK;
    }

    status = log_prepare_tx_buffer(&tx_buffer);
    if(status != LOG_STATUS_OK) {
        return status;
    }

    if(s_enable_color) {
        pos = log_append_text(tx_buffer, LOG_BUFFER_SIZE, pos, color);
    }

    pos = log_append_text(tx_buffer, LOG_BUFFER_SIZE, pos, tag);

    if(pos >= LOG_BUFFER_SIZE) {
        pos = LOG_BUFFER_SIZE - 1u;
    }

    remain = LOG_BUFFER_SIZE - pos;
    len = vsnprintf(&tx_buffer[pos], remain, format, args);
    if(len < 0) {
        return LOG_STATUS_INVALID_PARAM;
    }

    if((uint32_t)len >= remain) {
        pos = LOG_BUFFER_SIZE - 1u;
    }
    else {
        pos += (uint32_t)len;
    }

    if(s_enable_color) {
        pos = log_append_text(tx_buffer, LOG_BUFFER_SIZE, pos, LOG_COLOR_RESET);
    }

    pos = log_append_text(tx_buffer, LOG_BUFFER_SIZE, pos, "\r\n");

    if(pos >= LOG_BUFFER_SIZE) {
        pos = LOG_BUFFER_SIZE - 1u;
    }

    return log_commit_tx_buffer(pos);
}

static uint32_t log_append_text(char* buffer, uint32_t size, uint32_t pos, const char* text) {
    uint32_t i = 0u;

    if(buffer == 0 || size == 0u || text == 0) {
        return pos;
    }

    while(text[i] != '\0' && pos + 1u < size) {
        buffer[pos] = text[i];
        pos++;
        i++;
    }

    if(pos < size) {
        buffer[pos] = '\0';
    }

    return pos;
}

static uint32_t log_append_format(char* buffer, uint32_t size, uint32_t pos, const char* format, ...) {
    va_list args;
    int len;
    uint32_t remain;

    if(buffer == 0 || size == 0u || format == 0 || pos >= size) {
        return pos;
    }

    remain = size - pos;

    va_start(args, format);
    len = vsnprintf(&buffer[pos], remain, format, args);
    va_end(args);

    if(len < 0) {
        return pos;
    }

    if((uint32_t)len >= remain) {
        return size - 1u;
    }

    return pos + (uint32_t)len;
}

static uint32_t log_append_u64(char* buffer, uint32_t size, uint32_t pos, unsigned long long value) {
    char digits[20];
    uint32_t count = 0u;

    if(buffer == 0 || size == 0u || pos >= size) {
        return pos;
    }

    if(value == 0ull) {
        if(pos + 1u < size) {
            buffer[pos++] = '0';
            buffer[pos] = '\0';
        }
        return pos;
    }

    while(value > 0ull && count < (uint32_t)sizeof(digits)) {
        digits[count++] = (char)('0' + (value % 10ull));
        value /= 10ull;
    }

    while(count > 0u && pos + 1u < size) {
        buffer[pos++] = digits[--count];
    }

    buffer[pos] = '\0';
    return pos;
}

static uint32_t log_append_i64(char* buffer, uint32_t size, uint32_t pos, long long value) {
    unsigned long long magnitude;

    if(buffer == 0 || size == 0u || pos >= size) {
        return pos;
    }

    if(value < 0ll) {
        if(pos + 1u >= size) {
            return pos;
        }

        buffer[pos++] = '-';
        buffer[pos] = '\0';
        magnitude = (unsigned long long)(-(value + 1ll)) + 1ull;
        return log_append_u64(buffer, size, pos, magnitude);
    }

    return log_append_u64(buffer, size, pos, (unsigned long long)value);
}

static uint32_t log_append_vofa_value(char* buffer, uint32_t size, uint32_t pos, const LogVofaValue* value) {
    if(value == 0) {
        return pos;
    }

    switch(value->type) {
        case LOG_VOFA_VALUE_I64:
            return log_append_i64(buffer, size, pos, value->data.i64);

        case LOG_VOFA_VALUE_U64:
            return log_append_u64(buffer, size, pos, value->data.u64);

        case LOG_VOFA_VALUE_F64:
            return log_append_format(buffer, size, pos, "%.6f", value->data.f64);

        case LOG_VOFA_VALUE_BOOL:
            return log_append_text(buffer, size, pos, value->data.bool_value ? "1" : "0");

        case LOG_VOFA_VALUE_CSTR:
            return log_append_text(buffer, size, pos, value->data.cstr != 0 ? value->data.cstr : "(null)");

        case LOG_VOFA_VALUE_PTR:
            return log_append_format(buffer, size, pos, "%p", value->data.ptr);

        default:
            return log_append_text(buffer, size, pos, "?");
    }
}

static LogStatus log_prepare_tx_buffer(char** tx_buffer) {
    if(tx_buffer == 0) {
        return LOG_STATUS_INVALID_PARAM;
    }

    if(s_ops == 0 || s_ops->write == 0) {
        return LOG_STATUS_NOT_INITIALIZED;
    }

    if(s_async_write) {
        if(s_tx_count >= LOG_QUEUE_DEPTH) {
            return LOG_STATUS_BUSY;
        }

        *tx_buffer = s_tx_queue[s_tx_tail];
    }
    else {
        *tx_buffer = s_tx_queue[0];
    }

    return LOG_STATUS_OK;
}

static LogStatus log_commit_tx_buffer(uint32_t len) {
    if(len >= LOG_BUFFER_SIZE) {
        len = LOG_BUFFER_SIZE - 1u;
    }

    if(s_async_write) {
        s_tx_len_queue[s_tx_tail] = len;
        s_tx_tail = (s_tx_tail + 1u) % LOG_QUEUE_DEPTH;
        s_tx_count++;
        return log_start_async_write();
    }

    if(s_ops->write(s_tx_queue[0], len) == false) {
        return LOG_STATUS_PORT_ERROR;
    }

    return LOG_STATUS_OK;
}

static LogStatus log_start_async_write(void) {
    if(!s_async_write || s_write_busy || s_tx_count == 0u) {
        return LOG_STATUS_OK;
    }

    s_write_busy = true;

    if(s_ops->write(s_tx_queue[s_tx_head], s_tx_len_queue[s_tx_head]) == false) {
        s_write_busy = false;
        return LOG_STATUS_PORT_ERROR;
    }

    return LOG_STATUS_OK;
}
