LHC0821/2026TI-match-ball-system/src/service/assemble/assemble_balance.c

/**
 * @file assemble_balance.c
 * @brief 滚球平衡控制参数装配
 */

#include "assemble.h"

#include "../../app/app_config.h"
#include "balance.h"
#include "delay.h"
#include "log.h"
#include "main.h"

// ! ========================= 私 有 函 数 声 明 ========================= ! //

/**
 * @brief 读取 PA2 小车出发输入
 * @return 高电平返回 true，低电平返回 false
 */
static bool assemble_balance_start_signal_active(void);

// ! ========================= 接 口 函 数 实 现 ========================= ! //

SystemStatus assemble_balance(void) {
    BalanceConfig config = {
        .port_ops = {
            .now_ms = delay_now_ms,
            .start_signal_active = assemble_balance_start_signal_active,
            .prepare_motor = assemble_motor_prepare,
        },
        .motor_id = APP_CFG_MOTOR_ID,
        .motor_zero_rad = APP_CFG_MOTOR_ZERO_RAD,
        .motor_min_rad = APP_CFG_MOTOR_MIN_RAD,
        .motor_max_rad = APP_CFG_MOTOR_MAX_RAD,
        .motor_vel_rad_s = APP_CFG_MOTOR_VEL_RAD_S,
        .motor_kp = APP_CFG_MOTOR_KP,
        .motor_kd = APP_CFG_MOTOR_KD,
        .motor_tor_nm = APP_CFG_MOTOR_TOR_NM,
        .tor_pitch_gain = APP_CFG_TOR_PITCH_GAIN,
        .motor_sign = APP_CFG_MOTOR_SIGN,
        .acc_axis = APP_CFG_ACC_AXIS,
        .acc_sign = APP_CFG_ACC_SIGN,
        .pitch_sign = APP_CFG_PITCH_SIGN,
        .ball_sign = APP_CFG_BALL_SIGN,
        .level_gain = APP_CFG_LEVEL_GAIN,
        .acc_gain = APP_CFG_ACC_GAIN,
        .start_ff_angle_rad = APP_CFG_START_FF_ANGLE_RAD,
        .acc_tau_s = APP_CFG_ACC_TAU_S,
        .acc_fast_tau_s = APP_CFG_ACC_FAST_TAU_S,
        .acc_fast_enter_m_s2 = APP_CFG_ACC_FAST_ENTER_M_S2,
        .acc_fast_exit_m_s2 = APP_CFG_ACC_FAST_EXIT_M_S2,
        .vision_tau_s = APP_CFG_VISION_TAU_S,
        .vision_kp = APP_CFG_VISION_KP,
        .vision_ki = APP_CFG_VISION_KI,
        .vision_kd = APP_CFG_VISION_KD,
        .vision_kff = APP_CFG_VISION_KFF,
        .vision_max_angle_rad = APP_CFG_VISION_MAX_ANGLE_RAD,
        .calib_settle_ms = APP_CFG_CALIB_SETTLE_MS,
        .calib_samples = APP_CFG_CALIB_SAMPLES,
        .ctrl_mask = APP_CFG_CTRL_MASK,
        .auto_enable = APP_CFG_AUTO_ENABLE,
    };

    if(balance_init(&config) != BALANCE_STATUS_OK) {
        return SYSTEM_STATUS_ERROR;
    }

    log_info("BALANCE control ready");
    return SYSTEM_STATUS_OK;
}

// ! ========================= 私 有 函 数 实 现 ========================= ! //

static bool assemble_balance_start_signal_active(void) {
    return HAL_GPIO_ReadPin(CAR_START_GPIO_Port, CAR_START_Pin) ==
           GPIO_PIN_SET;
}
