LHC0821/2026TI-match-ball-system/src/infra/binary_frame.h

#ifndef _binary_frame_h_
#define _binary_frame_h_

/**
 * @file binary_frame.h
 * @brief 通用二进制帧协议辅助接口
 */

#include <stdbool.h>
#include <stdint.h>

// ! ========================= 宏 定 义 声 明 ========================= ! //

#define BINARY_FRAME_SOF0 0xA5u
#define BINARY_FRAME_SOF1 0x5Au
#define BINARY_FRAME_PROTOCOL_VERSION 0x01u
#define BINARY_FRAME_HEADER_SIZE 2u
#define BINARY_FRAME_LENGTH_FIELD_SIZE 2u
#define BINARY_FRAME_BODY_PREFIX_SIZE 4u
#define BINARY_FRAME_CRC_SIZE 2u
#define BINARY_FRAME_FIXED_OVERHEAD (BINARY_FRAME_HEADER_SIZE + BINARY_FRAME_LENGTH_FIELD_SIZE + BINARY_FRAME_CRC_SIZE)

#define BINARY_FRAME_FLAG_NEED_ACK 0x01u

// ! ========================= 类 型 声 明 ========================= ! //

/**
 * @brief BinaryFrameView 结构体类型
 */
typedef struct {
    uint8_t version;
    uint8_t msg_id;
    uint8_t seq;
    uint8_t flags;
    const uint8_t* payload;
    uint16_t payload_len;
} BinaryFrameView;

// ! ========================= 接 口 函 数 声 明 ========================= ! //

/**
 * @brief binary_frame_pack 接口函数
 * @param msg_id 消息 ID
 * @param seq 帧序号
 * @param flags 帧标志位
 * @param payload 负载数据指针
 * @param payload_len 负载长度
 * @param out 输出缓冲区或输出参数
 * @param out_size 输出缓冲区容量
 * @param out_len 输出长度
 * @return true 表示成功或条件成立，false 表示失败或条件不成立
 */
bool binary_frame_pack(uint8_t msg_id,
                       uint8_t seq,
                       uint8_t flags,
                       const uint8_t* payload,
                       uint16_t payload_len,
                       uint8_t* out,
                       uint16_t out_size,
                       uint16_t* out_len);

/**
 * @brief binary_frame_parse_body 接口函数
 * @param body 帧体缓冲区
 * @param body_len 帧体长度
 * @param view 输出帧视图
 * @return true 表示成功或条件成立，false 表示失败或条件不成立
 */
bool binary_frame_parse_body(const uint8_t* body,
                             uint16_t body_len,
                             BinaryFrameView* view);

/**
 * @brief binary_frame_crc16_ccitt 接口函数
 * @param data 数据缓冲区指针
 * @param len 数据长度
 * @return 返回值
 */
uint16_t binary_frame_crc16_ccitt(const uint8_t* data, uint16_t len);

/**
 * @brief binary_frame_read_u16_le 接口函数
 * @param data 数据缓冲区指针
 * @return 返回值
 */
uint16_t binary_frame_read_u16_le(const uint8_t* data);
/**
 * @brief binary_frame_read_i16_le 接口函数
 * @param data 数据缓冲区指针
 * @return 返回值
 */
int16_t binary_frame_read_i16_le(const uint8_t* data);
/**
 * @brief binary_frame_read_u32_le 接口函数
 * @param data 数据缓冲区指针
 * @return 返回值
 */
uint32_t binary_frame_read_u32_le(const uint8_t* data);
/**
 * @brief binary_frame_read_i32_le 接口函数
 * @param data 数据缓冲区指针
 * @return 返回值
 */
int32_t binary_frame_read_i32_le(const uint8_t* data);

/**
 * @brief binary_frame_write_u16_le 接口函数
 * @param data 数据缓冲区指针
 * @param value 数值
 */
void binary_frame_write_u16_le(uint8_t* data, uint16_t value);
/**
 * @brief binary_frame_write_i16_le 接口函数
 * @param data 数据缓冲区指针
 * @param value 数值
 */
void binary_frame_write_i16_le(uint8_t* data, int16_t value);
/**
 * @brief binary_frame_write_u32_le 接口函数
 * @param data 数据缓冲区指针
 * @param value 数值
 */
void binary_frame_write_u32_le(uint8_t* data, uint32_t value);
/**
 * @brief binary_frame_write_i32_le 接口函数
 * @param data 数据缓冲区指针
 * @param value 数值
 */
void binary_frame_write_i32_le(uint8_t* data, int32_t value);

/**
 * @brief binary_frame_urad_to_rad 接口函数
 * @param urad 参数值
 * @return 返回值
 */
float binary_frame_urad_to_rad(int32_t urad);
/**
 * @brief binary_frame_rad_to_urad 接口函数
 * @param rad 参数值
 * @return 返回值
 */
int32_t binary_frame_rad_to_urad(float rad);
/**
 * @brief binary_frame_mrad_to_rad 接口函数
 * @param mrad 参数值
 * @return 返回值
 */
float binary_frame_mrad_to_rad(int32_t mrad);
/**
 * @brief binary_frame_rad_to_mrad_i16 接口函数
 * @param rad 参数值
 * @return 返回值
 */
int16_t binary_frame_rad_to_mrad_i16(float rad);
/**
 * @brief binary_frame_mm_to_m 接口函数
 * @param mm 参数值
 * @return 返回值
 */
float binary_frame_mm_to_m(int32_t mm);
/**
 * @brief binary_frame_m_to_mm_i16 接口函数
 * @param m 参数值
 * @return 返回值
 */
int16_t binary_frame_m_to_mm_i16(float m);
/**
 * @brief binary_frame_m_to_mm_i32 接口函数
 * @param m 参数值
 * @return 返回值
 */
int32_t binary_frame_m_to_mm_i32(float m);
/**
 * @brief binary_frame_unit_to_e6_i32 接口函数
 * @param value 数值
 * @return 返回值
 */
int32_t binary_frame_unit_to_e6_i32(float value);
/**
 * @brief binary_frame_unit_to_q15_i16 接口函数
 * @param value 数值
 * @return 返回值
 */
int16_t binary_frame_unit_to_q15_i16(float value);

#endif
