LHC0821/2026TI-match-ball-system/src/service/assemble/assemble_log.c

#include "assemble.h"

#include "log.h"
#include "stm32_hal_uart.h"

// ! ========================= 变 量 声 明 ========================= ! //

static const LogPortOps log_ops = {
    .write = uart1_write_it,
};

// ! ========================= 接 口 函 数 实 现 ========================= ! //

SystemStatus assemble_log(void) {
    LogConfig log_config = {
        .ops = &log_ops,
        .level = LOG_LEVEL_INFO,
        .enable_color = true,
        .async_write = false,
    };

    if(log_init(&log_config) != LOG_STATUS_OK) {
        return SYSTEM_STATUS_ERROR;
    }

    return SYSTEM_STATUS_OK;
}
