LHC0821/2026TI-match-ball-system/src/service/assemble/assemble_tim.c

#include "assemble.h"

#include "log.h"
#include "stm32_hal_tim.h"

// ! ========================= 变 量 声 明 ========================= ! //

volatile uint32_t tim6_500hz_pending = 0u;

// ! ========================= 私 有 函 数 声 明 ========================= ! //

/**
 * @brief tim6_callback 内部辅助函数
 */
static void tim6_callback(void);

// ! ========================= 接 口 函 数 实 现 ========================= ! //

SystemStatus assemble_tim6_500hz(void) {
    tim_register_callback(&htim6, tim6_callback);
    tim_start();
    log_info("Tim6 started");
    return SYSTEM_STATUS_OK;
}

// ! ========================= 私 有 函 数 实 现 ========================= ! //

static void tim6_callback(void) {
    if(tim6_500hz_pending < UINT32_MAX) {
        tim6_500hz_pending++;
    }
}
