LHC0821/2026TI-match-ball-system/src/service/assemble/assemble_rgb.c

#include "assemble.h"

#include "rgb_led/rgb_led.h"
#include "rgb_led/ws2812_rgb_led.h"
#include "stm32_hal_spi.h"

// ! ========================= 变 量 声 明 ========================= ! //

static uint8_t rgb_color_buffer[WS2812_RGB_LED_DEFAULT_PIXEL_COUNT * RGB_LED_COLOR_BYTES];
static uint8_t rgb_tx_buffer[WS2812_RGB_LED_DEFAULT_PIXEL_COUNT * WS2812_RGB_LED_BITS_PER_PIXEL + WS2812_RGB_LED_DEFAULT_RESET_BYTES]
__attribute__((section(".ram_d3"), aligned(32)));

static const RgbLedPortOps rgb_ops = {
    .write = spi_write,
};

// ! ========================= 私 有 函 数 声 明 ========================= ! //

/**
 * @brief rgb_led_write_complete_callback 内部辅助函数
 * @param hspi SPI 句柄指针
 */
static void rgb_led_write_complete_callback(SPI_HandleTypeDef* hspi);

// ! ========================= 接 口 函 数 实 现 ========================= ! //

SystemStatus assemble_rgb(void) {
    RgbLedConfig rgb_config;

    if(rgb_led_set_instance(&ws2812_rgb_led_instance) != RGB_LED_STATUS_OK) {
        return SYSTEM_STATUS_ERROR;
    }

    if(ws2812_rgb_led_make_config(
        &rgb_config,
        &rgb_ops,
        rgb_color_buffer,
        sizeof(rgb_color_buffer),
        rgb_tx_buffer,
        sizeof(rgb_tx_buffer)) != RGB_LED_STATUS_OK) {
        return SYSTEM_STATUS_ERROR;
    }

    rgb_config.async_write = true;

    if(rgb_led.init(&rgb_config) != RGB_LED_STATUS_OK) {
        return SYSTEM_STATUS_ERROR;
    }

    spi_register_tx_complete_callback(&hspi6, rgb_led_write_complete_callback);
    rgb_led.fill(255U, 0U, 0U);
    rgb_led.show();
    return SYSTEM_STATUS_OK;
}

// ! ========================= 私 有 函 数 实 现 ========================= ! //

static void rgb_led_write_complete_callback(SPI_HandleTypeDef* hspi) {
    (void)hspi;
    (void)rgb_led_write_complete();
}
