LHC0821/2026TI-match-ball-system/src/service/assemble/assemble_delay.c

#include "assemble.h"

#include "delay.h"
#include "stm32_hal_dwt.h"
#include "main.h" // IWYU pragma: keep

// ! ========================= 变 量 声 明 ========================= ! //

#define ASSEMBLE_BOOT_SETTLE_DELAY_MS 1500u

// ! ========================= 私 有 函 数 声 明 ========================= ! //



// ! ========================= 接 口 函 数 实 现 ========================= ! //

SystemStatus assemble_delay(void) {
    dwt_init();

    delay_ms_init(HAL_GetTick);
    delay_us_init(dwt_get_us);

    delay_ms(ASSEMBLE_BOOT_SETTLE_DELAY_MS);

    return SYSTEM_STATUS_OK;
}

// ! ========================= 私 有 函 数 实 现 ========================= ! //
