LHC0821/2026TI-match-ball-system/(commit log)

2026-07-29 feat(driver): 电赛 H 题所有驱动测试完成
2026-07-29 docs: 更新全局注释
2026-07-29 feat(tune): 新增无线调参
2026-07-29 docs(config): 详细说明每个配置项的用途和示例
2026-07-29 docs(config): 详细补充配置项的可选项
2026-07-29 feat(motor): 切换到 mit 模式, 先保证能动 bug(motor): pos_vel 模式有点问题, 先切换到 mit 模式, 先保证能动
2026-07-30 fix(config): 修改配置参数
2026-07-30 feat(config): 简化配置项
2026-07-30 feat(motor): 对 mit 模式增加电机位置外环积分补偿
2026-07-30 feat(vision): 新增视觉超时机制
2026-07-30 fix(pos_vel): 旧版固件的协议, 修复无法用位置速度模式的问题
2026-07-30 featmotor): 切回 Mit 模式 feat(wireless): 移除无线调参的 APPLY/CANCEL 命令, 新增 MOTOR 命令
2026-07-30 feat(balance): 基于 MIT 的姿态+加速度+视觉平衡滚珠控制闭环
2026-07-30 feat(log): 优化日志显示
2026-07-30 feat(motor): 电机调参
2026-07-30 feat(config): 更新上下限
2026-07-30 feat(config): 更新俯仰增益
2026-07-30 feat(vision): 更新协议, 使用视觉端的速度
2026-07-31 feat(balance): 双通道 acc + vision 控制，增加 acc 反向快速滤波功能
2026-07-31 feat(vision): 视觉统一为像素单位
2026-07-31 feat(acc): 用快速滤波替换反向滤波
2026-10-17 Import STM32 project and current changes
2026-10-28 新增了电赛的机械建模文件以及硬件电源和控制板子的设计
2026-10-30 完善了readme中关于系统的各类阐述，同时给出此系统的架构
